jiu-0317/sense_pcb_kicad/docs/Sense_보드_설계검토_기록.docx

# Reptitude Sense 보드 (ESP32-C3) 설계 검토 · 수정 기록

프로젝트: D:\jiu\kicad\sense_pcb_kicad (esp32_c3_mini_1_module.kicad_sch / .kicad_pcb, KiCad 10, git 브랜치 usb_added)

문서 버전: v1.6 · 최초 작성 2026-11-09 · 최종 수정 2026-11-10

용도: 설계 문제를 하나씩 수정할 때 쓰는 체크리스트이자, 새 Claude 세션을 시작할 때 맥락으로 주는 기록이다. 새 논의가 생기면 이 문서의 해당 섹션과 「변경 이력」을 갱신한다.

# 0. 새 세션용 요약 (먼저 읽을 것)

- 보드: SHT40 온습도 → ESP32-C3-MINI-1 → Wi-Fi로 서버 전송. AAA×3(4.5V) → TPS63802 벅-부스트 → 3.3V. 2층, 60.7×37.6mm, 건전지 홀더(BH-AAA-A1AJ024, THT)를 뒷면에 직접 실장.
- 이전 보드 대비 변경: 벅(TPS62162) → 벅-부스트(TPS63802), 건전지 전선 연결 → THT 홀더 직접 실장, 외부 USB-UART → 보드 USB-C(현재 CH340E). 레이아웃은 새로 했고 나머지 회로는 이전에 정상 동작한 보드와 동일.
- 검토 결과: 회로 연결 오류·미배선·쇼트는 없음. 다만 BOM 번호 오류, 안테나가 건전지 위에 놓인 배치, CH340·배터리 체커로 인한 대기전류 증가, TPS 아래 부유 구리섬 등이 확인됨(4장).
- 결정된 방향(3장): MINI-1 유지 + 안테나를 홀더 밖 왼쪽 영역으로 이동, CH340 제거 후 ESP32-C3 내장 USB 사용, BOM 번호는 나중에 일괄 수정, 나머지는 권고대로 수정.
- 아직 안 한 것: KiCad 자체 ERC/DRC(6장 명령어), 내장 USB 전환 후 대기전류 실측, 홀더 극성 실물 확인.

# 1. 보드 개요

Ref | 부품 | 역할 / 메모
U5 | ESP32-C3-MINI-1-N4 | MCU+Wi-Fi, PCB 안테나. 현재 180° 회전, 안테나가 아래쪽 가장자리
U3 | TPS63802DLAT | 벅-부스트 3.3V. EN=VIN, MODE=GND(PFM), PG→GPIO10(R5 100k 풀업)
L1 | XFL4015-471MEC 0.47µH | 데이터시트 권장 인덕터 그대로
R6 / R7 | 511k / 91k | FB 분압 → 3.3V (VFB 500mV)
C5 / C6 | 10µF / 22µF | TPS 입력 / 출력 캡
Q1 + D1 | DMG2305UX + SS14 | 전원 경로: USB 있으면 D1로 VIN 공급, Q1이 배터리 차단. 없으면 Q1 ON
Q2, R8, R9, R10, C7 | AO3401A, 1M, 330k, 100k, 10nF | 배터리 체커: GPIO3로 PMOS 스위치, 분압 → GPIO0(ADC1_CH0)
U2 | CH340E | USB-UART (제거 예정, 3장 D2)
U1 | USBLC6-2SC6 | USB ESD (유지)
J1 | USB4105 USB-C | CC 5.1k(R3/R4). 쉴드 다리 THT → 홀더 영역 위로 못 옮김
U4 | SHT40-AD1F-R2 | I2C SDA=GPIO6, SCL=GPIO5, 풀업 10k(R11/R12), 주소 0x44
S1 / S2 / S3 | SKRPACE010 | BOOT(GPIO9) / EN / GPIO1 사용자 버튼
D2 + R15 | LED + 150Ω | GPIO18 (내장 USB 사용 시 이동 필요)
U6 | BH-AAA-A1AJ024 | AAA×3 홀더, 뒷면. 52×37mm, 핀 간격 11.6mm, Ø3.3 구멍 2개

보드 형상 수치(검토 기준 좌표, mm): 외곽 x 89.23–149.94, y 80.52–118.11. 홀더 외곽 x 97.78–149.78, y 80.84–117.84 → 홀더가 없는 곳은 왼쪽 띠 x 89.23–97.78(폭 약 8.5mm)뿐. 현재 안테나 영역 x 107.2–120.4, y 111.8–117.2. J1(USB) y 약 93–104, MH1 (94.4, 85.1), MH2 (94.4, 113.1).

# 2. 검토 방법과 한계

- 작업 공간에 KiCad 10을 설치할 수 없어서 .kicad_sch / .kicad_pcb를 직접 파싱해 넷리스트·구리 형상·연결성·간격을 계산했다(전 넷 연결 확인, 쇼트 없음, 최소 간격 0.122mm @ J1 SBU2–VBUS).
- 폴더 안 PDF 10종(TPS63802, TPS62162, ESP32-C3-MINI-1, SHT4x, CH340, USBLC6, DMG2305UX, XFL4015, BH-AAA 홀더 도면, ESP32-C3-DevKitM-1 회로도)을 읽고 대조했다.
- KiCad 자체 ERC/DRC는 아직 실행하지 않음 → 6장 명령으로 실행 후 결과를 이 문서에 반영할 것.

# 3. 결정 사항

ID | 날짜 | 내용
D1 | 2026-11-09 | ESP32-C3-MINI-1을 그대로 쓰고, 안테나를 홀더 영역 밖 왼쪽 PCB로 옮긴다. 하우징이 허용하면 보드를 키워 Espressif 권장 킵아웃(안테나 주변 15mm에 구리·배선·부품 없음)을 지키고, 허용하지 않으면 현재 보드 크기로 진행한다.
D2 | 2026-11-09 | CH340E를 제거하고 ESP32-C3 내장 USB Serial/JTAG(IO18=D−, IO19=D+)를 쓴다. 목적: 소비자가 펌웨어 문제 시 USB로 직접 강제 플래싱.
D3 | 2026-11-09 | 내장 USB 전환 후 배터리 단독 대기전류를 측정하고, 많으면 펌웨어에서 D+ 풀업을 켜고 끄도록 한다. 펌웨어가 망가져도 플래싱이 가능해야 하므로 버튼으로 강제하는 방법도 고려 → 검토 의견은 5.3절.
D4 | 2026-11-09 | BOM/LCSC 번호 오류(S-01)는 나중에 한 번에 고친다. 그때까지 주문 금지.
D5 | 2026-11-09 | 그 외 지적 사항은 4장 권고대로 수정한다.
D6 | 2026-11-09 | 배터리 체커(S-04)는 안1로 결정: Q2(AO3401A) 유지 + 게이트 구동 NMOS Q3(AO3400A) 추가, R8을 4V5로. GPIO3=High일 때 측정(펌웨어 로직 반전). 작업 브랜치: git layout_v3.
D7 | 2026-11-09 | 회로도 최종: 과방전 방지 EN 분압·VIN 벌크 캡(S-06)은 적용하지 않음. 대기전류 측정용 솔더 점퍼 JP1 추가, UART0 테스트 패드 TP1~TP3 추가, EN 풀업 중복 정리(R14 삭제).
D8 | 2026-11-10 | PCB 배치에 맞춰 ESP32 핀맵 변경(5.2.2절 표). 데이터시트 기준 검토 결과 문제 없음.

# 4. 수정 항목 체크리스트

우선순위: 치명(주문하면 동작 안 함) > 높음 > 중간 > 낮음. 상태 열은 수정하면서 갱신한다(미착수 / 진행 / 완료 / 보류).

ID | 우선 | 항목 | 근거 / 수정 방법 | 상태
S-01 | 치명 | BOM·LCSC 필드 오류 | 회로도 심볼의 LCSC/MPN이 복사된 채 남음: C1~C6에 C28323(1µF), R1·R3·R4·R6·R7에 C84376(10k). JLC BOM(ver2_mfr)은 일부 수정됐지만 C1~C4, C6, R6, R7이 비어 있음. R6/R7 누락·오값 → 출력 약 1V로 ESP 미동작, C6 1µF → TPS 최소 출력 실효 7µF 미달. → 필드 정리, C6은 0805 22µF 10V X5R 등 실제 22µF 지정. | 보류(D4)
S-02 | 높음 | CH340E 상시 전원 | VCC/V3가 VDD33 → 배터리만으로도 동작, suspend 40µA typ / 150µA max. → D2 결정으로 CH340 제거. | 회로도 완료
S-03 | 높음 | D+ 역류 누설 경로 | D+ 풀업 → USBLC6 I/O→VBUS 다이오드(rail-to-rail) → +VBUS → R1 → VBUSF → R2(100k) → GND. CH340 기준 약 27µA 추정. ESP 내장 USB도 D+ 내부 풀업이 있고 VBUS 감지가 없어 비슷한 경로 가능. → 내장 USB 전환 후 실측, 필요 시 펌웨어로 풀업 OFF(5.3절). | 미착수
S-04 | 중간 | 배터리 체커 Q2가 꺼지지 않음 | R8이 3.3V로 게이트를 당기는데 소스는 배터리 4.5~4.8V → Vgs −1.2~−1.5V, AO3401A Vth −0.5~−1.3V라 ON 유지 → 분압기로 상시 약 11µA. 이전 보드도 같은 구조(측정은 정상). → 안1: R8을 4V5에 연결 + GPIO3로 NMOS(2N7002, 게이트 100k 풀다운) 구동해 Q2 게이트를 당김. → 안2: 스위치 제거, 분압기를 1M/330k 등 고저항으로(약 3.5µA) + C7 유지. [반영] 안1 적용(D6): Q3 AO3400A(G=GPIO3, S=GND, D=Q2 게이트), R8 1M → 4V5, R10 100k는 GPIO3 풀다운으로 용도 변경, 분압 하단은 R20 100k 신규. Q3 LCSC 필드는 S-01 때 함께 입력. | 회로도 완료
S-05 | 낮음 | SS14 역누설 | 배터리 단독 시 VIN→D1(역방향)→VBUSF→R2 경로. 상온 수 µA, 사육장 온도에서 증가. → 대기전류 측정 시 함께 확인. 크면 저누설 다이오드 검토. | 미착수
S-06 | 낮음 | (선택) 과방전 방지·벌크 캡 | TPS EN=VIN이라 1.25V까지 동작 → 알카라인 과방전. → EN에 분압(예: 2.7V 컷오프, 1.7M/1M 수준, 약 1.6µA) 또는 펌웨어 컷오프. → VIN에 47~100µF 벌크 캡: 건전지 말기 Wi-Fi 버스트 전압 강하 완화. [결정] 둘 다 적용하지 않음(D7). 저전압 처리는 필요 시 펌웨어(ADC)로. | 미적용
P-01 | 높음 | 안테나가 건전지 위 | 현재 안테나 영역 전체가 뒷면 홀더(셀 금속 캔, 스프링)와 겹침 → 디튜닝·통신 거리 감소. → D1: 왼쪽 띠로 이동. 배치 가이드는 5.1절. | 결정(D1)
P-02 | 높음 | TPS 아래 B.Cu 부유 구리섬 | VIN_ind / NET_ind(SW) / NET_ind_1(L2) / VDD33_ind 존이 F.Cu+B.Cu로 지정 → B.Cu에 어디에도 연결 안 된 섬 4개(약 21mm²)가 GND 플레인을 끊음. SW 섬은 노이즈원. → 이 존들을 F.Cu 전용으로 변경. GND_ind는 유지 가능. | 미착수
P-03 | 중간 | ESP 3V3 디커플링 거리 | C12(0.1µF)/C13(10µF)가 3V3 핀(3번)에서 9~12mm. → 3번 핀 바로 옆으로 이동(안테나 이동 시 같이 재배치). | 미착수
P-04 | 중간 | SHT40 아래 구리 / 위치 | Sensirion: 패드 외 구리 금지(다이 패드 납땜도 비권장). 현재 F.Cu 일부·B.Cu 전체 GND가 아래에 있음. → 센서 아래 양면 킵아웃, 가능하면 보드 가장자리 + 주변 슬롯으로 열 분리, 열원(TPS, ESP, LED)과 거리 확보. | 미착수
P-05 | 중간 | 솔더마스크 확장 0.1mm | pad_to_mask_clearance 0.1 → 0.5mm 피치(TPS63802, USB-C)에서 패드 사이 마스크 소실. → 0으로 변경(제조사 기본 확장 사용). | 미착수
P-06 | 낮음 | 홀더 핀 길이 | 홀더 핀 12.7mm → 윗면으로 약 11mm 돌출. 납땜 후 절단 필요(조립 지침에 기록). | 미착수
P-07 | 중간 | 홀더 극성 확인 | 도면상 가운데 핀이 −로 보이고 풋프린트(1=GND 가운데, 2=4V5)와 일치하나 도면에 핀 표기가 없음. → 주문 전 실물을 멀티미터로 확인. | 미착수
P-08 | 제약 | USB-C 위치 | USB4105 쉴드 다리 4개가 THT → 뒷면 홀더와 간섭하므로 왼쪽 띠에 남겨야 함(또는 전체 SMD 타입 커넥터로 교체). | —
P-09 | 중간 | 장착 구멍 MH1/MH2 | 안테나를 왼쪽 띠로 옮기면 구멍이 겹치거나 가까워짐. 금속 나사도 금속. → 안테나 쪽 구멍 제거 또는 나일론 나사. 고정은 홀더 Ø3.3 구멍 활용 검토. | 미착수
C-01 | 높음 | LED GPIO18 이동 | 내장 USB가 IO18/IO19를 사용 → LED(D2/R15)를 빈 핀(IO4 또는 IO7)으로 이동. [반영] R15 → GPIO7. | 회로도 완료

# 5. 상세 가이드

## 5.1 안테나 + USB 왼쪽 띠 배치 (P-01, P-08, P-09) — Espressif PCB Layout 가이드 반영

가이드 요지(ESP32-C3 Hardware Design Guidelines, PCB Layout Design): ① 모듈의 PCB 안테나를 베이스 보드 밖으로 내보내고 급전점(feed point)을 보드 가장자리 가까이 둘 것(가장 권장). ② 밖으로 못 내면 급전점을 최대한 가장자리에 붙이고, 안테나 양옆과 아래의 베이스 보드를 잘라낼 것. ③ 모듈을 보드 가운데 두고 사방을 파내는 배치는 금지. ④ 안테나 근처 베이스 보드에 GND 동박과 촘촘한 GND 비아. ⑤ 하우징 안에서 안테나 주변 모든 방향 15mm 이상 여유. ⑥ 최종 제품에서 통신 거리·처리량 시험. ESP32-C3-MINI-1의 급전점은 안테나의 왼쪽 끝(안테나를 위로 둔 윗면 기준, 1번 핀 쪽).

- 모듈 방향: 90° 반시계 회전(안테나가 −x, 왼쪽을 향함). 이때 급전점(안테나 왼쪽 끝)은 아래쪽(+y)으로 감 → 모듈을 보드 왼쪽 아래 모서리에 두어 급전점이 모서리(가장자리) 가까이 오게 함.
- 안1(권장) 안테나 돌출: 모듈 패드부를 왼쪽 띠에 두고 안테나 부분(약 5.4×13.2mm)이 베이스 보드 왼쪽 가장자리 밖으로 나가게 배치. 베이스 보드 외곽은 그대로, 제품 폭만 약 5.4mm 늘어남(하우징 확인). 안테나–홀더 간격 약 8~9mm로 증가.
- 안2 보드 안 + 컷아웃: 안테나를 왼쪽 띠 안(x 약 89.2–94.6)에 두고, 안테나 아래와 양옆(위·아래) 베이스 보드를 Edge.Cuts로 U자 노치 형태로 제거. 급전점 쪽(아래)을 보드 가장자리에 최대한 붙임. 안테나–홀더 간격 약 3~5mm.
- 공통: USB-C는 왼쪽 띠 위쪽으로 이동(쉴드 THT 때문에 왼쪽 띠 고정). MH1(왼쪽 위)은 USB와, MH2(왼쪽 아래)는 안테나와 겹치므로 제거 또는 이동(금속 나사는 안테나에서 멀리). 안테나 영역 양면 구리·부품·배선 금지(모듈 풋프린트 킵아웃 유지). 모듈 본체 아래·주변은 GND 동박 + 촘촘한 GND 비아, 모듈 GND 패드(49) 비아 9개 이상.
- 보드를 늘릴 수 있으면: 왼쪽으로 늘려 안테나–셀/홀더 금속 간격 15mm를 목표로(D1).
- 시제품에서 실제 설치 위치 RSSI·통신 거리를 측정하고 가능하면 DevKit과 비교. 부족하면 ESP32-C3-MINI-1U(같은 핀, U.FL 외장 안테나) 검토.

## 5.2 내장 USB 전환 회로 변경 (D2)

- U2(CH340E)와 전용 디커플링(C3/C4 중 CH340용) 삭제. USBLC6 출력 D+ → U5 27번(IO19), D− → U5 26번(IO18). 각 라인에 0Ω 자리 확보(Espressif 참고 회로와 동일).
- 유지: USB-C CC 5.1k(R3/R4), USBLC6, VBUS 전원 경로(R1, D1, Q1, R2), BOOT(S1, GPIO9)·EN(S2) 버튼, GPIO8 풀업(R18 — 다운로드 모드 진입에 GPIO8 High 필요), GPIO2 풀업(R17).
- [회로도 반영 2026-11-09] CH340E·C3·C4 삭제. USBD+ → USBLC6 I/O2(3,4) → U5 27번(IO19), USBD− → USBLC6 I/O1(1,6) → U5 26번(IO18) 확인. 0Ω 직렬 자리는 넣지 않음(선택 사항). 레이아웃에서는 커넥터 → USBLC6 패드 → ESP 순서로 지나가도록 배선(클램프가 경로 위에 오게).
- UART0(TXD0 31번, RXD0 30번)은 테스트 패드로 남겨 두면 USB 문제 시 디버깅 백업이 됨(선택).
- 펌웨어 설정: Arduino는 「USB CDC On Boot: Enabled」, ESP-IDF는 콘솔을 USB Serial/JTAG로.
- 한계: 기능 고정(시리얼+JTAG)이라 HID 같은 커스텀 USB 장치는 불가. 딥슬립 중에는 USB가 끊기고 COM 포트가 사라짐.

## 5.2.1 회로도 최종 추가 사항 (D7)

- JP1 (Jumper:SolderJumper_2_Bridged, 풋프린트 SolderJumper-2_P1.3mm_Bridged_RoundedPad1.0x1.5mm): BAT+(홀더 +) ↔ 4V5 사이. 평소 연결 상태, 대기전류 측정 시 가운데 동박을 칼로 끊고 멀티미터를 직렬 연결(빨강=BAT+ 쪽, 검정=4V5 쪽), 측정 후 납으로 재연결. PCB에서는 윗면 손 닿는 곳에 배치.
- 측정 팁: 부팅·Wi-Fi 중에는 µA 레인지의 내부 저항 때문에 리셋될 수 있음 → 점퍼를 이은 상태나 mA 레인지로 시작해 딥슬립 진입 후 µA로 전환. 전류 모드로 전원–GND 사이에 대지 말 것.
- TP1~TP3 (Connector:TestPoint, TestPoint_Pad_D1.5mm): TP1=RXD0(30번), TP2=TXD0(31번), TP3=GND. 윗면에 2.54mm 간격 일렬 배치, 실크 RX/TX/GND. 외부 USB-UART는 보드 TX→어댑터 RX, 보드 RX←어댑터 TX, GND만 연결(어댑터 전원 핀 연결 금지).
- EN: R14 삭제, R16 10k + C11 1µF + C10 0.1µF (Espressif 권장 10k/1µF 수준).
- 남은 회로도 항목: S-01 BOM 필드(Q3 LCSC 포함, JP1·TP1~3·FID·MH는 실장 부품 아님), MH1/MH2 유지 여부는 레이아웃에서 결정(P-09).

## 5.2.2 ESP32-C3 핀맵 (D8, 2026-11-10)

모듈 핀 | GPIO | 연결 | 데이터시트 근거 / 메모
5 | IO2 | R17 10k 풀업 | 스트래핑. Table 4-3: SPI·다운로드 부트 모두 1 권장(글리치 방지)
6 | IO3 | NC | 예비(ADC1_CH3)
8 | EN | R16 10k + C11 1µF + C10, S2 | EN 플로팅 금지. RC 약 11ms > 스트래핑 hold 3ms
12 | IO0 | S3 사용자 버튼, R15 10k 풀업, C14 | 비스트래핑. XTAL_32K_P 겸용(32k 크리스털 미사용)
13 | IO1 | 배터리 ADC (R9 330k / R11 100k, C7) | ADC1_CH1: ADC1은 공장 보정됨(ADC2는 미보정·일부 리비전 불가)
16 | IO10 | LED D2 (R19 150Ω) | 일반 GPIO
18 | IO4 | SHT40 SDA, R13 10k | I2C는 GPIO 매트릭스로 아무 핀 가능. MTMS(핀 JTAG 기본 비활성)
19 | IO5 | SHT40 SCL, R12 10k | SDA와 인접 핀
20 | IO6 | Q3 게이트(배터리 체커), R10 100k 풀다운 | 딥슬립 시 핀이 떠도 풀다운으로 Q3 OFF. High=측정
21 | IO7 | TPS63802 PG, R5 100k 풀업 | 오픈드레인 입력
22 | IO8 | R18 10k 풀업 | 스트래핑: 다운로드 부트에 1 필요, ROM 로그 출력 제어
23 | IO9 | S1 BOOT, R14 10k 풀업, C9 0.1µF | 스트래핑: 0이면 다운로드 모드. RC 약 1ms로 EN보다 먼저 안정
26/27 | IO18/IO19 | USB D−/D+ | USB Serial/JTAG
30/31 | RXD0/TXD0 | 테스트 패드 RX0/TX0 | UART0 백업

참고: 회로도 레퍼런스 번호가 재정렬됨(예: 배터리 분압 하단 R11, GPIO9 풀업 R14, LED 저항 R19, 테스트 패드 RX0/TX0/GND0). 4장 체크리스트의 부품 번호는 v1.3 이전 기준.

펌웨어 메모: 사용자 버튼을 IO0에 둔 것은 딥슬립 해제에 유리함(ESP32-C3는 GPIO0~5만 딥슬립 GPIO 웨이크업 가능 — 칩 문서 기준). SHT40은 Wire.begin(4, 5).

## 5.3 강제 플래싱과 D+ 풀업 제어 (D3) — 검토 의견

- 핵심: GPIO9(BOOT)를 Low로 누른 채 리셋(EN)하면 ESP32-C3는 ROM 부트로더로 들어가고, ROM이 직접 USB Serial/JTAG 다운로드 모드("wait usb download")를 띄운다. 플래시의 펌웨어는 실행되지 않으므로 펌웨어 로직과 무관하게 강제 플래싱이 가능하다.
- 펌웨어가 USB 풀업을 꺼 두었더라도, EN 버튼(CHIP_PU)으로 리셋하면 칩 레지스터가 초기화되어 ROM 상태로 다시 시작한다. 따라서 「버튼으로 풀업 강제 ON」 회로는 BOOT+EN 버튼으로 이미 대체될 가능성이 높다 → 별도 회로 추가 전에 시제품에서 확인 권장.
- 꼭 지킬 것: eFuse DIS_USB_SERIAL_JTAG, DIS_USB_SERIAL_JTAG_DOWNLOAD_MODE를 굽지 말 것(굽으면 USB 강제 플래싱이 영구히 불가).
- 소비자용 복구 절차(안): ① USB 연결 ② BOOT 누른 상태 유지 ③ EN 짧게 누름 ④ BOOT 놓음 ⑤ 플래싱 도구 실행 ⑥ 완료 후 EN 눌러 재시작.
- 대기전류가 많게 나오면: 딥슬립 진입 전에 펌웨어에서 USB D+ 풀업을 끄고(USB Serial/JTAG 패드 설정), 깨어난 뒤 필요할 때만 켠다. 이 경우에도 BOOT+EN 복구 경로는 그대로 유효.

## 5.4 대기전류 예산 (배터리 단독, 추정)

항목 | 전류 | 비고
TPS63802 Iq | 약 11µA | 데이터시트 typ
ESP32-C3 딥슬립 | 약 5µA | RTC 타이머+메모리
CH340E (현재) | 40µA typ / 150µA max | D2로 제거 예정
D+ → USBLC6 → VBUS → R2 누설 | 약 27µA (CH340 기준 추정) | 내장 USB 후 실측(S-03)
Q2 분압기 상시 전류 | 약 11µA | S-04 수정 시 0~3.5µA
SS14 역누설 | 수 µA (온도↑ 시 증가) | S-05
설계 목표 합계 | 약 16µA | TPS + ESP 딥슬립
현재 구조 추정 합계 | 약 80~100µA | 측정으로 확인 필요

## 5.5 라우팅 검토 (2026-11-10, 16:15 저장본)

범위: 연결 완결성, TPS63802 전원부, 전원 배선 폭, ESP32 모듈, 안테나, USB, 배터리 측정부, SHT40, GND 면 연속성, 제조·조립. GND 비아 개수·배치는 사용자가 추가할 예정이라 제외. KiCad DRC가 아니라 파일 직접 파싱으로 확인했으므로 최종은 DRC로 재확인.

ID | 우선 | 문제 | 조치
R-01 | 해제 | (v1.6 정정) U3 핀 사이 GND 비아 0.5/0.2mm는 JLCPCB 현행 기준(2층 최소 홀 0.15, 권장 0.2, 지름 0.45 이상이면 추가비 없음)에 맞음. 패드 간격 0.197mm도 SMD 패드 간 0.15·보드 규칙 0.15 이상, 홀–패드 0.35mm(기준 0.2). | 조치 불필요. 유지.
R-02 | 높음 | JP1(D7에서 결정)이 회로도·PCB 모두에 없음. R1(0R)은 VBUS 경로라 배터리 대기전류 측정용이 아님. | 의도적 삭제인지 확인. 필요하면 배터리 경로(4V5)에 다시 추가.
R-03 | 중간 | SHT40 디커플링 C8(100nF)이 U4 3번 핀까지 배선 약 9mm. | C8을 U4 3·4번 핀 바로 옆으로 이동.
R-04 | 중간 | B.Cu VDD33 배선(107.4,116.9→118,107.8)과 GPIO1 배선(118.2,109.9→144.4,101.7)이 이어져 B면 GND를 길게 가름. (107.4,116.9) 비아가 보드 아래 가장자리까지 막아 아래쪽 영역은 오른쪽 끝(x>145)으로만 연결. | 해당 비아를 위로 올려 아래로 GND가 지나가게 하거나 그 구간을 F.Cu로. 갈라진 양쪽을 GND 비아로 이음.
R-05 | 중간 | 안테나 킵아웃 모서리(보드 쪽 0.85mm 띠, x 94.24–95.09)에 GND 채움이 0.1–0.3mm까지 붙음. GND 비아(91.3,96.9) 2.1mm, R3 2.4mm, C12 0.8mm. | 킵아웃 위·아래로 약 3mm 연장한 룰 영역(채움·비아 금지) 추가, (91.3,96.9) 비아 이동.
R-06 | 중간 | 실크 문구 Ver.2 Reptitude Sense, ENABLE, GPIO1, BOOT가 보드 밖(y 74–78)에 있어 인쇄 안 됨. S3는 이제 IO0이라 GPIO1 표기도 틀림. | 보드 안으로 이동, S3 표기를 USER(IO0)로.
R-07 | 중간 | 홀더(U6) 극성 실크 없음(B면). 풋프린트는 1번=GND(y 99.3), 2번=+(y 87.7). | 데이터시트로 극성 확인(P-07) 후 B.SilkS에 +/− 표기.
R-08 | 높음 | pad_to_mask 0.1 그대로(P-05). 마스크 댐 = 패드 간격 − 0.2 → U3 0.05mm, J1(다른 넷) 0.0mm로 JLCPCB 최소 0.10mm(녹색, 1oz) 미달 → 패드 사이 마스크 없음, 브리지 위험. JLCPCB는 개구를 패드와 1:1로 만듦. | 0으로 변경 → U3 0.25, J1 0.20, U1 0.35mm.
R-09 | 낮음 | VBUS 배선이 J1 B8(SBU2, 미연결)과 0.122mm, B5(CC2)와 0.175mm. JLCPCB 패드–트랙 0.1은 만족하나 보드 규칙 0.15 미만이라 DRC 오류. 마스크 0.1이면 트랙이 노출됨(개구–트랙 0.09 필요). | 배선 살짝 이동(R-08 수정 시 노출 문제는 해소).
R-10 | 낮음 | VIN 0.4mm × 29mm. 최저 전압 2.7V, 약 0.5A 기준 전압강하 약 17mV로 허용 범위. | 여유 있으면 0.5–0.75mm로.
R-11 | 낮음 | ADC(GPIO1) 배선 약 49mm. C7이 분압기 쪽에 있어 실용상 문제는 적음. | 선택: 노이즈 시 모듈 쪽에 소용량 캡 추가 검토.
R-12 | 낮음 | 부품 번호 실크 대부분 0.7mm/선 0.1mm(C7은 0.39mm). JLCPCB 최소 글자 높이 1.0mm·선 0.15mm 미만 → 흐리거나 안 읽힐 수 있음. 풋프린트 실크 선 0.12–0.127mm도 기준 미만이나 라이브러리 기본값. | 필요한 글자만 1.0mm/0.15mm로. 패드–실크 0.15mm는 모두 만족.

JLCPCB 기준 대조(v1.6, jlcpcb.com/capabilities/pcb-capabilities): 비아 홀–트랙 ≥0.2, PTH 홀–구리 ≥0.28, NPTH–트랙 ≥0.2, 홀 간격 모두 만족. NPTH J1 0.65·홀더 3.3mm(최소 0.5). PTH 링 홀더 0.5mm, J1 쉴드 0.2mm(권장 0.25, 최소 0.18 — 라이브러리 값). 외곽–구리 0.5mm(기준 0.2). 보드 규칙(간격 0.15, 비아 0.45)은 JLCPCB보다 보수적이라 유지해도 됨.

정상 확인: 미배선 없음, 회로도와 PCB 넷 일치, 다른 넷 간 0.15mm 미만 간격은 R-09뿐, 외곽 이격 ≥0.5mm. TPS 입력 루프(C5–10번–8번–GND_ind) 약 3.5mm·출력 C6 근접, SW/L2 구리 짧음, FB 분압기 핀 근처·SW와 분리, R7 GND가 AGND(3번)로 연결. ESP 3번 핀 옆 C12(0.1µF)·C13(10µF), EN 1µF(C11) 모듈 근처. USB는 J1→USBLC6(약 4mm)→모듈, 비아 없음, 길이 D+ 19.3 / D− 22.8mm(FS에 무관), CC 5.1k. 안테나는 노치 위로 돌출, 풋프린트 킵아웃 안에 구리 없음. 모듈 GND 패드 전부 연결. SHT40 킵아웃 유지. Q2/Q3 배터리 스위치 소형 배치.

# 6. ERC/DRC 실행 명령 (PowerShell)

cd D:\jiu\kicad\sense_pcb_kicad

$k="C:\Program Files\KiCad\10.0\bin\kicad-cli.exe"

& $k sch erc --severity-all -o erc.rpt esp32_c3_mini_1_module.kicad_sch

& $k pcb drc --schematic-parity --severity-all -o drc.rpt esp32_c3_mini_1_module.kicad_pcb

& $k sch export pdf -o sch.pdf esp32_c3_mini_1_module.kicad_sch

# 7. 정상으로 확인된 항목

- 넷 연결: 모든 넷 끊김 없음, 서로 다른 넷 간 쇼트 없음.
- ESP32-C3 핀 매핑: 3V3(3), EN(8), IO0/1/2/3/5/6/8/9/10/18, TXD0(31)/RXD0(30) 모두 데이터시트와 일치. UART 크로스(CH340 TXD→RXD0, TXD0→CH340 RXD) 정상.
- 스트래핑: GPIO2·GPIO8 10k 풀업, GPIO9 BOOT 버튼+10k 풀업+0.1µF, EN 10k×2 + 1.1µF(권장 10k/1µF 수준).
- TPS63802: 핀 기능·풋프린트가 DLA0010A 랜드 패턴과 일치, 핀 8 페이스트 있음(2분할), FB 511k/91k=3.3V, MODE=GND, PG→GPIO10(100k), L1 0.47µH XFL4015, C5/C6/L1 배치와 IC 가운데 GND 비아는 TI 예시 형태. 비아 텐팅 ON.
- 전원 경로: USB 시 Q1 게이트 5V·소스 약 4.7V → OFF로 배터리 차단, 배터리 시 Q1 ON(Vgs −2.7V에서도 RDS(on) ≤100mΩ), 배터리 역삽입 시에도 Q1이 차단.
- USB-C: CC 5.1k, D+/D− 양면 핀 연결, USBLC6 방향(I/O1 1↔6, I/O2 3↔4, VBUS 5) 정상. VBUS 0.3mm 트랙은 0.5A 수준에 충분.
- SHT40: 핀(SDA1/SCL2/VDD3/VSS4), 10k 풀업(최소 390Ω 이상), C8 100nF 3mm 이내, 다이 패드 없음.
- 홀더 풋프린트: Ø3.3 구멍 간격 23.5mm, 핀 간격 11.6mm가 도면과 일치, 뒷면 배치 시 미러 방향이 맞음.
- J1 USB-C: 보드 가장자리 대비 약 0.36mm 돌출(플러그 체결에 유리).
- 배터리 ADC: GPIO0(ADC1_CH0), 4.8V → 약 1.12V, 2.7V → 약 0.63V, C7 10nF로 샘플링 안정.

# 8. 데이터시트 근거 메모

- TPS63802: 입력 1.3–5.5V(시동 1.8V 이상), UVLO 하강 1.25V. 권장 L 0.47µH(실효 0.37–0.57), 출력 실효 C ≥7µF(VO>2.3V), 입력 실효 ≥4µF, 권장 출력 22µF·입력 10µF. VFB 500mV, 하측 저항 ≤100k. 레이아웃: 입출력 캡 IC에 최대한 가깝게, 전력/제어 GND 분리 후 IC 근처에서 연결, FB 트레이스는 L1/L2에서 멀리. EN 임계 상승 1.1V/하강 1.0V(분압으로 UVLO 설정 가능).
- ESP32-C3-MINI-1: 13.2×16.6mm, GND 1·2·11·14·36–53, 3V3=3, EN=8, IO18=USB_D−(26), IO19=USB_D+(27). 딥슬립 약 5µA. 안테나 킵아웃: 안테나 아래 구리 금지, 가장자리 배치, 권장 위치가 안 되면 주변 15mm 비움.
- ESP32-C3 부트: GPIO9 Low로 리셋 → ROM 다운로드 모드(USB Serial/JTAG 또는 UART0). GPIO8은 High 필요.
- SHT4x: VDD 1.08–3.6V, 풀업 ≥390Ω(VDD≥1.62V), 센서 아래 패드 외 구리 금지, 다이 패드 납땜 비권장.
- CH340: 3.3V 동작 시 V3=VCC, 동작 4–12mA, USB suspend 0.04–0.15mA(CH340C/N/E/X), 내부 D+ 풀업 내장. CH340X는 CH340E 개선판(6번 핀 DTR 전환 가능, 역류 방지) — 내장 USB로 가면 불필요.
- USBLC6-2SC6: rail-to-rail 구조(I/O→VBUS 다이오드), 누설 ≤150nA.
- DMG2305UX: VGS(th) −0.5~−0.9V, VGSS ±8V, RDS(on) ≤100mΩ@−2.5V. 핀 1=G, 2=S, 3=D.
- XFL4015-471: 0.47µH, DCR 7.6mΩ, Isat(20%) 5.4A, 랜드 0.98×3.4mm, 중심 간격 2.37mm.
- BH-AAA-A1AJ024: 52×37×12.8mm, 2-Ø3.3 구멍(간격 23.5), 핀 간격 11.6, 핀 길이 12.7mm.

# 9. 지적 위치도

노란 번호: 1=안테나(P-01), 2=TPS 부유 구리섬(P-02), 3=Q2 배터리 체커(S-04), 4=CH340(S-02), 5=ESP 디커플링(P-03), 6=SHT40(P-04). 파란 점선=뒷면 홀더, 빨간 영역=현재 안테나.

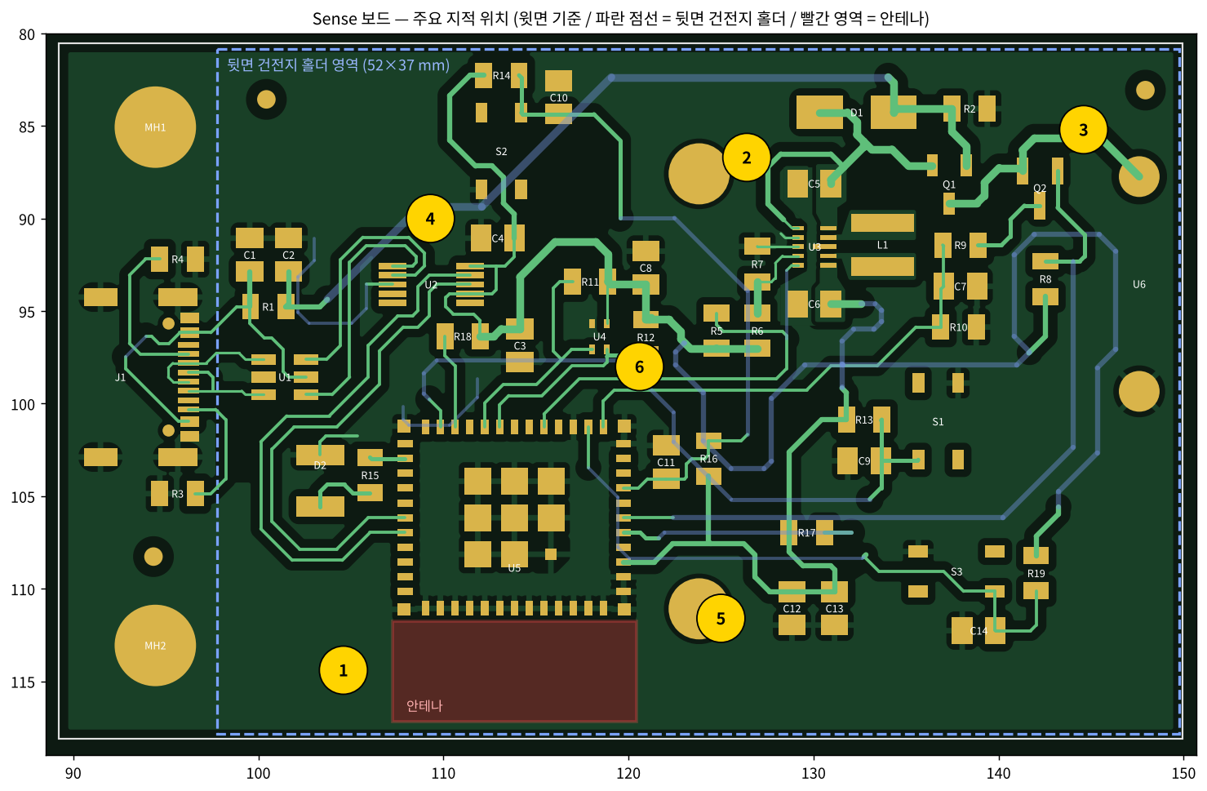
[picture p1: figure]

# 10. 열린 질문 / 다음 확인

- 하우징 크기: 보드를 왼쪽으로 늘려 안테나 15mm 확보가 가능한가?
- 내장 USB 전환 후 배터리 단독 대기전류 실측값(목표 약 16~20µA) — JP1로 측정.
- BOOT+EN 복구 경로로 충분한지(5.3절) — 별도 풀업 강제 버튼이 필요한지 시제품에서 결정.
- ERC/DRC 결과 반영.

# 11. 변경 이력

날짜 | 내용
2026-11-09 | v1.0 최초 작성: 회로·PCB 검토 결과, 결정 D1~D5, 수정 체크리스트, 내장 USB 전환·안테나 재배치 가이드.
2026-11-09 | v1.1 회로도 수정 확인(브랜치 layout_v3): CH340 제거·내장 USB 연결, LED GPIO7 이동, 배터리 체커 안1 적용(D6). S-02·S-04·C-01 상태 갱신.
2026-11-09 | v1.2 회로도 최종 확인(D7): JP1·TP1~3 추가, R14 삭제, S-06 미적용 결정. 다음 단계는 레이아웃.
2026-11-09 | v1.3 5.1절을 Espressif PCB Layout 가이드 기준으로 갱신(급전점 위치, 안테나 돌출 권장, 컷아웃 대안, 모듈 방향·모서리 배치).
2026-11-10 | v1.4 ESP32 핀맵 변경 검토(D8, 5.2.2절).
2026-11-10 | v1.5 라우팅 검토(5.5절, R-01~R-11).
2026-11-10 | v1.6 JLCPCB 현행 제조 기준으로 재검토: R-01 해제(비아 0.2mm 허용), R-08 높음으로 상향, R-09 보강, R-12 추가.
