jiu-0317/sense_pcb_kicad/ver2_mfr/BOM.csv

Reference | Qty | Value | DNP | Exclude from BOM | Exclude from Board | Footprint | Datasheet | Description_1 | MANUFACTURER | MF_part_number | Package | LCSC
C5,C13 | 2 | 10uF |  |  |  | Custom:CAPC2012X95N | https://www.lcsc.com/datasheet/C17024.pdf,https://www.lcsc.com/datasheet/C28323.pdf | 10uF ±10% 10V Ceramic Capacitor X5R 0805,1uF ±10% 50V Ceramic Capacitor X7R 0805 | Samsung Electro-Mechanics | CL21A106KPFNNNE,CL21B105KBFNNNE | 0805 | C17024,C28323
R2,R5,R10 | 3 | 100k |  |  |  | Custom:RESC2012X60N | https://www.lcsc.com/datasheet/C84376.pdf,https://www.lcsc.com/datasheet/C96346.pdf | 125mW 100kΩ 150V Thick Film Resistor ±100ppm/℃ ±1% 0805 Chip Resistor - Surface Mount RoHS,125mW 10kΩ 150V Thick Film Resistor ±100ppm/℃ ±1% 0805 Chip Resistor - Surface Mount RoHS | YAGEO | RC0805FR-07100KL,RC0805FR-0710KL | 0805 | C84376,C96346
C7 | 1 | 10nF |  |  |  | Custom:CAPC2012X95N | https://www.lcsc.com/datasheet/C1710.pdf | 10nF ±10% 50V Ceramic Capacitor X7R 0805 | Samsung Electro-Mechanics | CL21B103KBANNNC | 0805 | C1710
U1 | 1 | USBLC6-2SC6 |  |  |  | Package_TO_SOT_SMD:SOT-23-6 | https://www.st.com/resource/en/datasheet/usblc6-2.pdf | ESD DIODE 5.25VWM 17VC SOT-23-6L | ST | USBLC6-2SC6 | SOT-23-6L | C7519
Q2 | 1 | AO3401A |  |  |  | Package_TO_SOT_SMD:SOT-23 | http://www.aosmd.com/pdfs/datasheet/AO3401A.pdf | 30V 4A Surface Mount SOT-23 | AOS | AO3401A | SOT-23 | C15127
C1,C2,C3,C4 | 4 | 470n |  |  |  | Custom:CAPC2012X95N | https://www.lcsc.com/datasheet/C28323.pdf | 1uF ±10% 50V Ceramic Capacitor X7R 0805 | Samsung Electro-Mechanics | CL21B105KBFNNNE | 0805 | C28323
C6 | 1 | 22uF |  |  |  | Custom:CAPC2012X95N | https://www.lcsc.com/datasheet/C28323.pdf | 1uF ±10% 50V Ceramic Capacitor X7R 0805 | Samsung Electro-Mechanics | CL21B105KBFNNNE | 0805 | C28323
C11 | 1 | 1uF |  |  |  | Custom:CAPC2012X95N | https://www.lcsc.com/datasheet/C28323.pdf | 1uF ±10% 50V Ceramic Capacitor X7R 0805 | Samsung Electro-Mechanics | CL21B105KBFNNNE | 0805 | C28323
D1 | 1 | SS14 |  |  |  | Diode_SMD:D_SMA | https://www.vishay.com/docs/88746/ss12.pdf | DIODE SCHOTTKY 40V SMA(DO-214AC) | VISHAY | SS14-E3/61T | SMA(DO-214AC) | C47460
R1 | 1 | 0R |  |  |  | Custom:RESC2012X60N | https://www.lcsc.com/datasheet/C84376.pdf | 125mW 10kΩ 150V Thick Film Resistor ±100ppm/℃ ±1% 0805 Chip Resistor - Surface Mount RoHS | YAGEO | RC0805FR-0710KL | 0805 | C84376
R3,R4 | 2 | 5k1 |  |  |  | Custom:RESC2012X60N | https://www.lcsc.com/datasheet/C84376.pdf | 125mW 10kΩ 150V Thick Film Resistor ±100ppm/℃ ±1% 0805 Chip Resistor - Surface Mount RoHS | YAGEO | RC0805FR-0710KL | 0805 | C84376
R6 | 1 | 511k |  |  |  | Custom:RESC2012X60N | https://www.lcsc.com/datasheet/C84376.pdf | 125mW 10kΩ 150V Thick Film Resistor ±100ppm/℃ ±1% 0805 Chip Resistor - Surface Mount RoHS | YAGEO | RC0805FR-0710KL | 0805 | C84376
R7 | 1 | 91k |  |  |  | Custom:RESC2012X60N | https://www.lcsc.com/datasheet/C84376.pdf | 125mW 10kΩ 150V Thick Film Resistor ±100ppm/℃ ±1% 0805 Chip Resistor - Surface Mount RoHS | YAGEO | RC0805FR-0710KL | 0805 | C84376
R11,R12,R13,R14,R16,R17,R18,R19 | 8 | 10k |  |  |  | Custom:RESC2012X60N | https://www.lcsc.com/datasheet/C84376.pdf | 125mW 10kΩ 150V Thick Film Resistor ±100ppm/℃ ±1% 0805 Chip Resistor - Surface Mount RoHS | YAGEO | RC0805FR-0710KL | 0805 | C84376
U2 | 1 | CH340E |  |  |  | Package_SO:MSOP-10_3x3mm_P0.5mm | https://www.mpja.com/download/35227cpdata.pdf | USB to Serial Port Chip CH340 | WCH | CH340E | MSOP-10 | C99652
R8 | 1 | 1M |  |  |  | Custom:RESC2012X60N | https://www.lcsc.com/datasheet/C107700.pdf | 125mW 1MΩ 150V Thick Film Resistor ±100ppm/℃ ±1% 0805 Chip Resistor - Surface Mount RoHS | YAGEO | RC0805FR-071ML | 0805 | C107700
R15 | 1 | 150 |  |  |  | Custom:RESC2012X60N | https://www.lcsc.com/datasheet/C114523.pdf | 150Ω 125mW 150V Thick Film Resistor ±100ppm/℃ ±1% 0805 Chip Resistor - Surface Mount RoHS | YAGEO | RC0805FR-07150RL | 0805 | C114523
R9 | 1 | 330k |  |  |  | Custom:RESC2012X60N | https://www.lcsc.com/datasheet/C114528.pdf | 125mW 330kΩ 150V Thick Film Resistor ±100ppm/℃ ±1% 0805 Chip Resistor - Surface Mount RoHS | YAGEO | RC0805FR-07330KL | 0805 | C114528
S1,S2,S3 | 3 | SKRPACE010 |  |  |  | Custom:SW_SKRPACE010 | https://www.lcsc.com/datasheet/C139797.pdf | Switch Tactile N.O. SPST Button J-Bend 0.05A 16VDC 2.55N SMD Automotive T/R | ALPSALPINE | SKRPACE010 | SMD-4P,4.2x3.2mm | C139797
Q1 | 1 | DMG2305UX-13 |  |  |  | Custom:DMG2305UX-13 | https://s3.amazonaws.com/snapeda/datasheet/DMG2305UX-13_Diodes_Inc..pdf | MOSFET P-CH 20V 5A SOT-23 | Diodes Inc. | DMG2305UX-13 | SOT-23 | C144153
U3 | 1 | TPS63802DLAT |  |  |  | Custom:TPS63802DLAT | https://www.ti.com/lit/gpn/tps63802 | High-efficiency, low-IQ step-down/step-up converter in DFN package | TI | TPS63802DLAT | VSON-10(2x3) | C1849531
C8 | 1 | 100nF |  |  |  | Custom:CAPC2012X95N | https://www.lcsc.com/datasheet/C1852967.pdf | 100nF ±10% 10V Ceramic Capacitor X7R 0805 | YAGEO | CC0805KRX7R6BB104 | 0805 | C1852967
C9,C10,C12,C14 | 4 | 0.1uF |  |  |  | Custom:CAPC2012X95N | https://www.lcsc.com/datasheet/C1852967.pdf | 100nF ±10% 10V Ceramic Capacitor X7R 0805 | YAGEO | CC0805KRX7R6BB104 | 0805 | C1852967
U5 | 1 | ESP32-C3-MINI-1-N4 |  |  |  | Custom:XCVR_ESP32-C3-MINI-1-N4 | https://www.lcsc.com/datasheet/C2838502.pdf | Transceiver On-board PCB Antenna -98dBm SMD,16.6x13.2mm RF Transceiver Modules and Modems RoHS | Espressif Systems | ESP32-C3-MINI-1-N4 | SMD,16.6x13.2mm | C2838502
D2 | 1 | LED |  |  |  | Custom:XL-3528SURC | https://www.lcsc.com/datasheet/C2843800.pdf | LED RED WATER CLEAR SMD | XINGLIGHT | XL-3528SURC | SMD3528-2P | C2843800
J1 | 1 | USB_C_Receptacle_USB2.0_16P |  |  |  | Connector_USB:USB_C_Receptacle_GCT_USB4105-xx-A_16P_TopMnt_Horizontal | https://www.usb.org/sites/default/files/documents/usb_type-c.zip | USB Type C Receptacle for USB 2.0, SMT Type, PCB Top Mount | Global Connector Technology | USB4105-GF-A-060 | SMD | C3025063
U6 | 1 | BH-AAA-A1AJ024 |  |  |  | Custom:BAT-TH_BH-AAA-A1AJ024 | https://www.lcsc.com/datasheet/C5290193.pdf | BATTERY HOLDER CYLINDRICAL AAA | MYOUNG | BH-AAA-A1AJ024 | - | C5290193
U4 | 1 | SHT40-AD1F-R2 |  |  |  | Custom:SHT4X | https://jlcpcb.com/api/file/downloadByFileSystemAccessId/8590907640283279360 | -40℃~+125℃ 0%RH~100%RH 1.08V~3.6V 16bit 400nA I2C ±0.2℃ ±1.8%RH DFN-4(1.5x1.5) Temperature and Humidity Sensor ROHS | Sensirion | SHT40-AD1F-R2 | DFN-4(1.5x1.5) | C7461846
L1 | 1 | 0.47uH |  |  |  | Custom:xfl4015_inductor | https://www.coilcraft.com/getmedia/84927b8b-f089-421b-a7f4-a0fa23afe908/xfl4015.pdf | FIXED IND 470nH SMD,4x4mm | Coilcraft | XFL4015-471MEC | SMD,4x4mm | C18221164
