jiu-0317/sense_pcb_kicad/esp32_c3_mini_1_module.csv

Reference | Qty | Value | DNP | Exclude from BOM | Exclude from Board | Footprint | Datasheet | Description_1 | MANUFACTURER | MF_part_number | Package | LCSC
C1 | 1 | 1uF |  |  |  | Custom:CAPC2012X95N | https://www.lcsc.com/datasheet/C28323.pdf | 1uF ±10% 50V Ceramic Capacitor X7R 0805 | Samsung Electro-Mechanics | CL21B105KBFNNNE | 0805 | C28323
C2,C5,C7 | 3 | 0.1uF |  |  |  | Custom:CAPC2012X95N | https://www.lcsc.com/datasheet/C1852967.pdf | 100nF ±10% 10V Ceramic Capacitor X7R 0805 | YAGEO | CC0805KRX7R6BB104 | 0805 | C1852967
C3 | 1 | 10uF |  |  |  | Custom:CAPC2012X95N | https://www.lcsc.com/datasheet/C17024.pdf | 10uF ±10% 10V Ceramic Capacitor X5R 0805 | Samsung Electro-Mechanics | CL21A106KPFNNNE | 0805 | C17024
C4 | 1 | 10uf |  |  |  | Custom:CAPC2012X95N | ~ | 10uF ±20% 10V Ceramic Capacitor X5R 0805 | Kyocera AVX | 0805ZD106MAT2A | 0805 | C2170995
C6 | 1 | 10nF |  |  |  | Custom:CAPC2012X95N | https://www.lcsc.com/datasheet/C1710.pdf | 10nF ±10% 50V Ceramic Capacitor X7R 0805 | Samsung Electro-Mechanics | CL21B103KBANNNC | 0805 | C1710
C8 | 1 | 22uf |  |  |  | Custom:CAPC2012X95N | https://www.lcsc.com/datasheet/C307529.pdf | 22uF ±20% 10V Ceramic Capacitor X5R 0805 | Samsung Electro-Mechanics | CL21A226MPCLRNC | 0805 | C307529
C9 | 1 | 100nF |  |  |  | Custom:CAPC2012X95N | https://www.lcsc.com/datasheet/C1852967.pdf | 100nF ±10% 10V Ceramic Capacitor X7R 0805 | YAGEO | CC0805KRX7R6BB104 | 0805 | C1852967
D1 | 1 | LED |  |  |  | Custom:XL-3528SURC | https://www.lcsc.com/datasheet/C2843800.pdf | LED RED WATER CLEAR SMD | XINGLIGHT | XL-3528SURC | SMD3528-2P | C2843800
FID1,FID2,FID3 | 3 | Fiducial |  | Excluded from BOM |  | Fiducial:Fiducial_1mm_Mask2mm | ~
J1 | 1 | Conn_01x02_Socket |  | Excluded from BOM |  | Connector_JST:JST_XH_B2B-XH-A_1x02_P2.50mm_Vertical | https://www.lcsc.com/datasheet/C158012.pdf | Connector Header 2 position 2.5mm Pitch 3A Through Hole -25℃~+85℃ | JST | B2B-XH-A(LF)(SN) | Through Hole,P=2.5mm | C158012
J2 | 1 | uart_flash |  |  |  | Connector_PinSocket_2.54mm:PinSocket_1x06_P2.54mm_Horizontal | https://www.lcsc.com/datasheet/C2897388.pdf | -40℃~+105℃ Right Angle 6P 3A 8.5mm 1x6P Side 2.54mm 1 Square Hole Through Hole,Right Angle,P=2.54mm Headers, Receptacles, Female Sockets RoHS | HCTL | PM254-1-06-W-8.5 | Through Hole,Right Angle,P=2.54mm | C2897388
L1 | 1 | 2.2uH |  |  |  | Custom:IND_LPS3015-222MRC | https://www.coilcraft.com/getmedia/5d262731-85ef-4348-8ab4-1044b4fc3cb8/lps3015.pdf | 2.2 µH Shielded - Inductor 1.4 A 110mOhm Max Nonstandard - | Coilcraft | LPS3015-222MRC | SMD,3x3mm | C2844756
MH1,MH2,MH3,MH4 | 4 | M3 |  | Excluded from BOM |  | MountingHole:MountingHole_3.2mm_M3 | ~
PS1 | 1 | TPS62162DSGR |  |  |  | Custom:SON50P200X200X80-9N | https://www.lcsc.com/datasheet/C40256.pdf | 2.25MHz Buck Fixed 3.3V 1A WSON-8-EP(2x2) Voltage Regulators - DC DC Switching Regulators RoHS | Texas Instruments | TPS62162DSGR | WSON-8-EP(2x2) | C40256
Q1 | 1 | AO3401A |  |  |  | Package_TO_SOT_SMD:SOT-23 | http://www.aosmd.com/pdfs/datasheet/AO3401A.pdf | 30V 4A Surface Mount SOT-23 | AOS | AO3401A | SOT-23 | C15127
R1,R2,R3,R5,R9,R10,R11 | 7 | 10k |  |  |  | Custom:RESC2012X60N | https://www.lcsc.com/datasheet/C84376.pdf | 125mW 10kΩ 150V Thick Film Resistor ±100ppm/℃ ±1% 0805 Chip Resistor - Surface Mount RoHS | YAGEO | RC0805FR-0710KL | 0805 | C84376
R4 | 1 | 150 |  |  |  | Custom:RESC2012X60N | https://www.lcsc.com/datasheet/C114523.pdf | 150Ω 125mW 150V Thick Film Resistor ±100ppm/℃ ±1% 0805 Chip Resistor - Surface Mount RoHS | YAGEO | RC0805FR-07150RL | 0805 | C114523
R6 | 1 | 330k |  |  |  | Custom:RESC2012X60N | https://www.lcsc.com/datasheet/C114528.pdf | 125mW 330kΩ 150V Thick Film Resistor ±100ppm/℃ ±1% 0805 Chip Resistor - Surface Mount RoHS | YAGEO | RC0805FR-07330KL | 0805 | C114528
R7,R12 | 2 | 100k |  |  |  | Custom:RESC2012X60N | https://www.lcsc.com/datasheet/C96346.pdf | 125mW 100kΩ 150V Thick Film Resistor ±100ppm/℃ ±1% 0805 Chip Resistor - Surface Mount RoHS | YAGEO | RC0805FR-07100KL | 0805 | C96346
R8 | 1 | 1M |  |  |  | Custom:RESC2012X60N | https://www.lcsc.com/datasheet/C107700.pdf | 125mW 1MΩ 150V Thick Film Resistor ±100ppm/℃ ±1% 0805 Chip Resistor - Surface Mount RoHS | YAGEO | RC0805FR-071ML | 0805 | C107700
S1,S2 | 2 | SKRPACE010 |  |  |  | Custom:SW_SKRPACE010 | https://www.lcsc.com/datasheet/C139797.pdf | Switch Tactile N.O. SPST Button J-Bend 0.05A 16VDC 2.55N SMD Automotive T/R | ALPSALPINE | SKRPACE010 | SMD-4P,4.2x3.2mm | C139797
U1 | 1 | ESP32-C3-MINI-1-N4 |  |  |  | Custom:XCVR_ESP32-C3-MINI-1-N4 | https://www.lcsc.com/datasheet/C2838502.pdf | Transceiver On-board PCB Antenna -98dBm SMD,16.6x13.2mm RF Transceiver Modules and Modems RoHS | Espressif Systems | ESP32-C3-MINI-1-N4 | SMD,16.6x13.2mm | C2838502
U4 | 1 | SHT40-AD1F-R2 |  |  |  | Custom:SHT4X | https://jlcpcb.com/api/file/downloadByFileSystemAccessId/8590907640283279360 | -40℃~+125℃ 0%RH~100%RH 1.08V~3.6V 16bit 400nA I2C ±0.2℃ ±1.8%RH DFN-4(1.5x1.5) Temperature and Humidity Sensor ROHS | Sensirion | SHT40-AD1F-R2 | DFN-4(1.5x1.5) | C7461846
