jiu-0317/sense_pcb_kicad/3D/SOT-23-3L_AOS.step

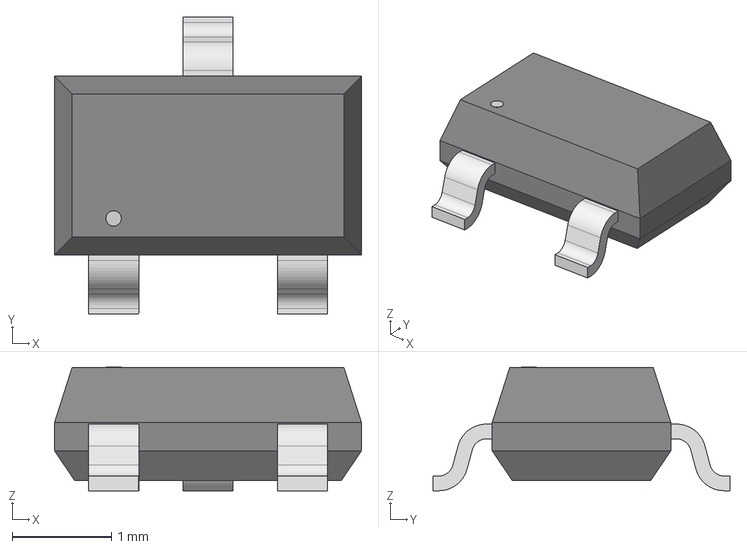
[picture p2: CAD file, 2026-11-04]
3D/SOT-23-3L_AOS.step
3.10 x 3.00 x 1.25 mm
