jiu-0317/sense_pcb_kicad/esp32_c3_mini_1_module.step

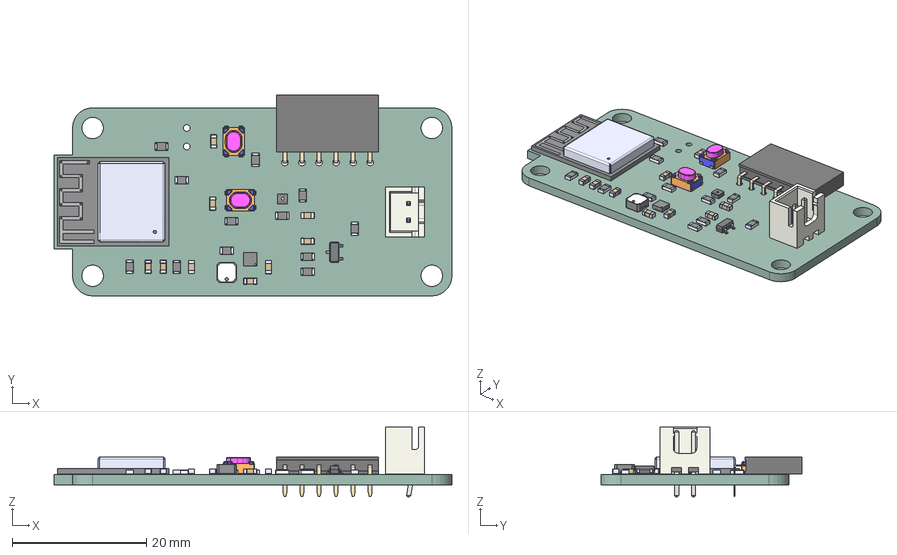
[picture p3: CAD file, 2026-11-04]
esp32_c3_mini_1_module.step
59.2 x 29.9 x 10.4 mm
RESC2012X60N x 12
CL21A226MPCLRNC x 9
PinSocket_1x06_P2.54mm_Horizontal
skrpace010 x 2
LPS3015-222MRC--3DModel-STEP-269445
SOT-23
ESP32-C3-MINI-1-N4
SHT40-AD1F-R2--3DModel-STEP-269445
TPS62162DSGR
JST_XH_B2B-XH-A_1x02_P2.50mm_Vertical
esp32_c3_mini_1_module_PCB
