jiu-0317/sense_pcb_kicad/xfl4015_inductor/XFL4015.STEP

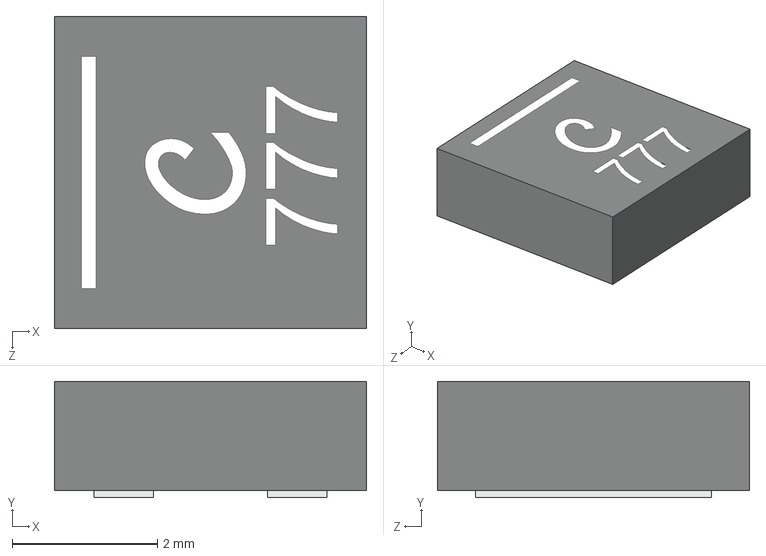
[picture p4: CAD file, 2026-11-06]
xfl4015_inductor/XFL4015.STEP
4.30 x 1.60 x 4.30 mm
