jiu-0317/sense_pcb_kicad/3D/skrpace010.stl

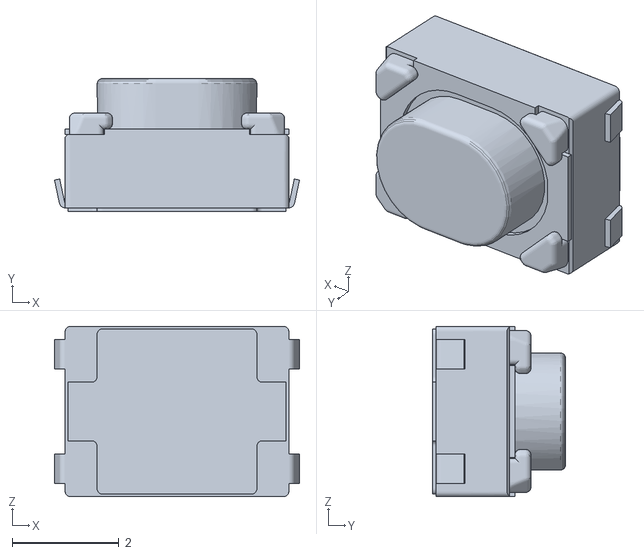
[picture p5: CAD file, 2026-11-04]
3D/skrpace010.stl
4.60 x 2.50 x 3.20
