jiu-0317/sense_pcb_kicad/3D/CL21A226MPCLRNC.STEP

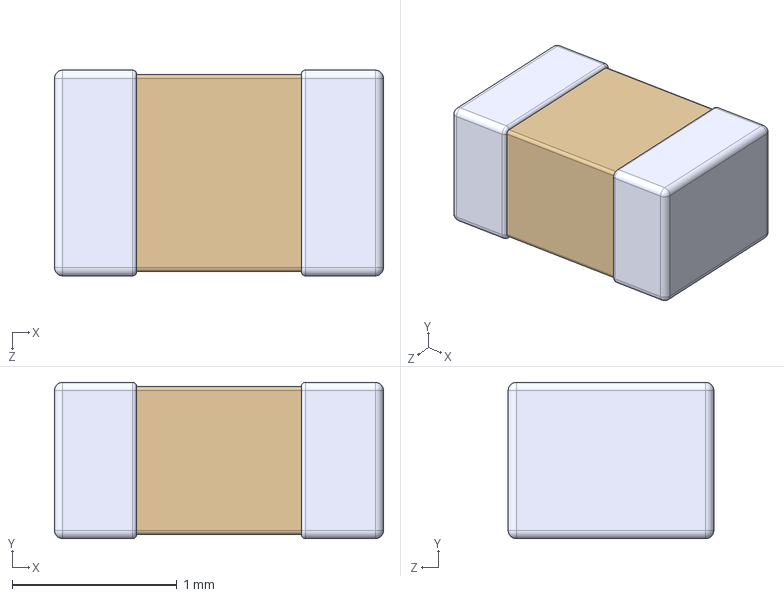
[picture p6: CAD file, 2026-11-04]
3D/CL21A226MPCLRNC.STEP
2.00 x 0.95 x 1.25 mm
