jiu-0317/sense_pcb_kicad/(list of files, cad)

Other CAD files:
esp32_c3_mini_1_module.stl
