jiu-0317/sense_pcb_kicad/SCH_ESP32-C3-DEVKITM-1_V1_20200915A.pdf

# System Block:

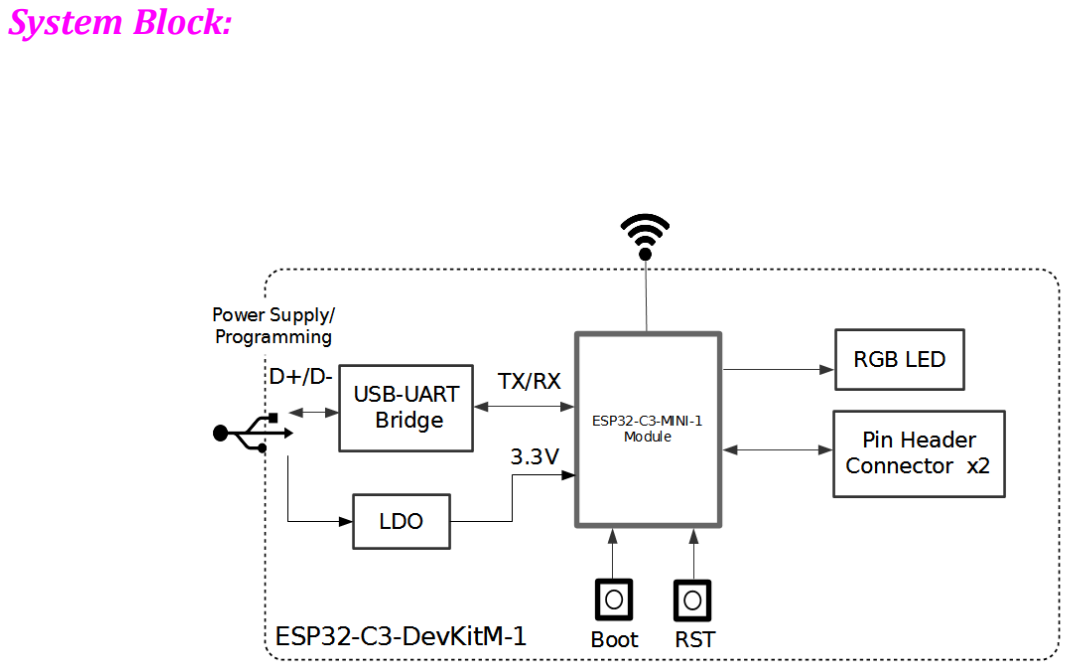
[picture p7: page 1]
Title; Size; Document Number; Rev; Date:; Sheet; <01_DesignBlock>; ESP32-C3-DevKitM-1; Tuesday, September 15, 2020

NC8 | 25 IO18 | 26 IO19 | 27 NC9 | 28 NC10 | 29 RXD0 | 30 TXD0 | 31 NC11 | 32 NC12 | 33 NC13 | 34 NC14 | 35

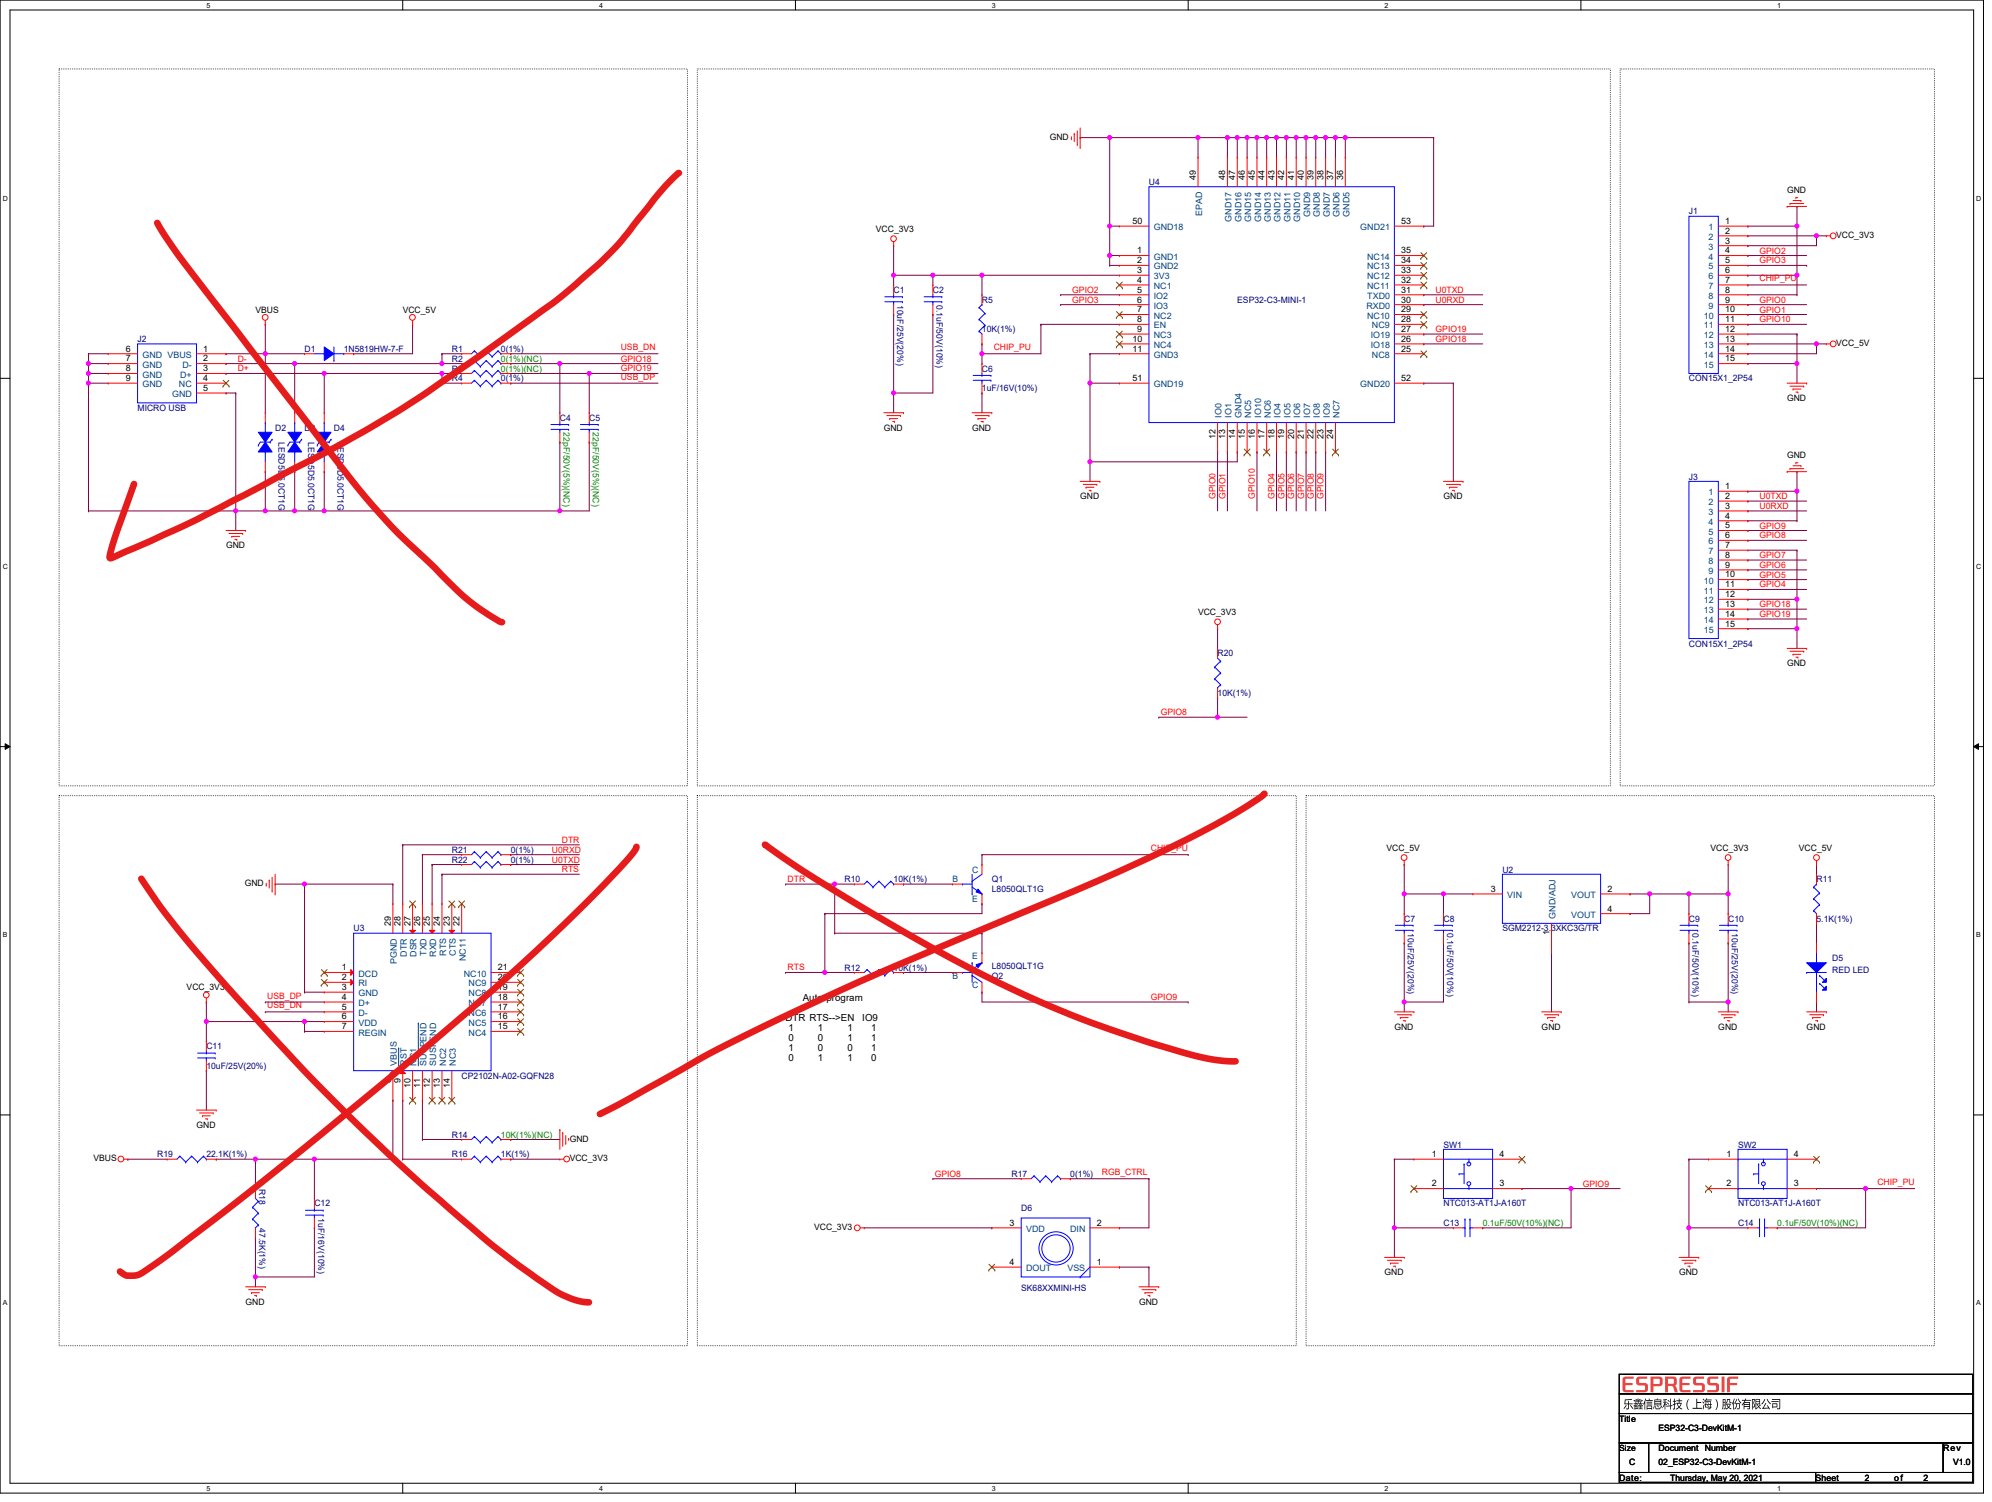
[picture p8: page 2]
