jiu-0317/sense_pcb_kicad/BH-AAA-3J.pdf

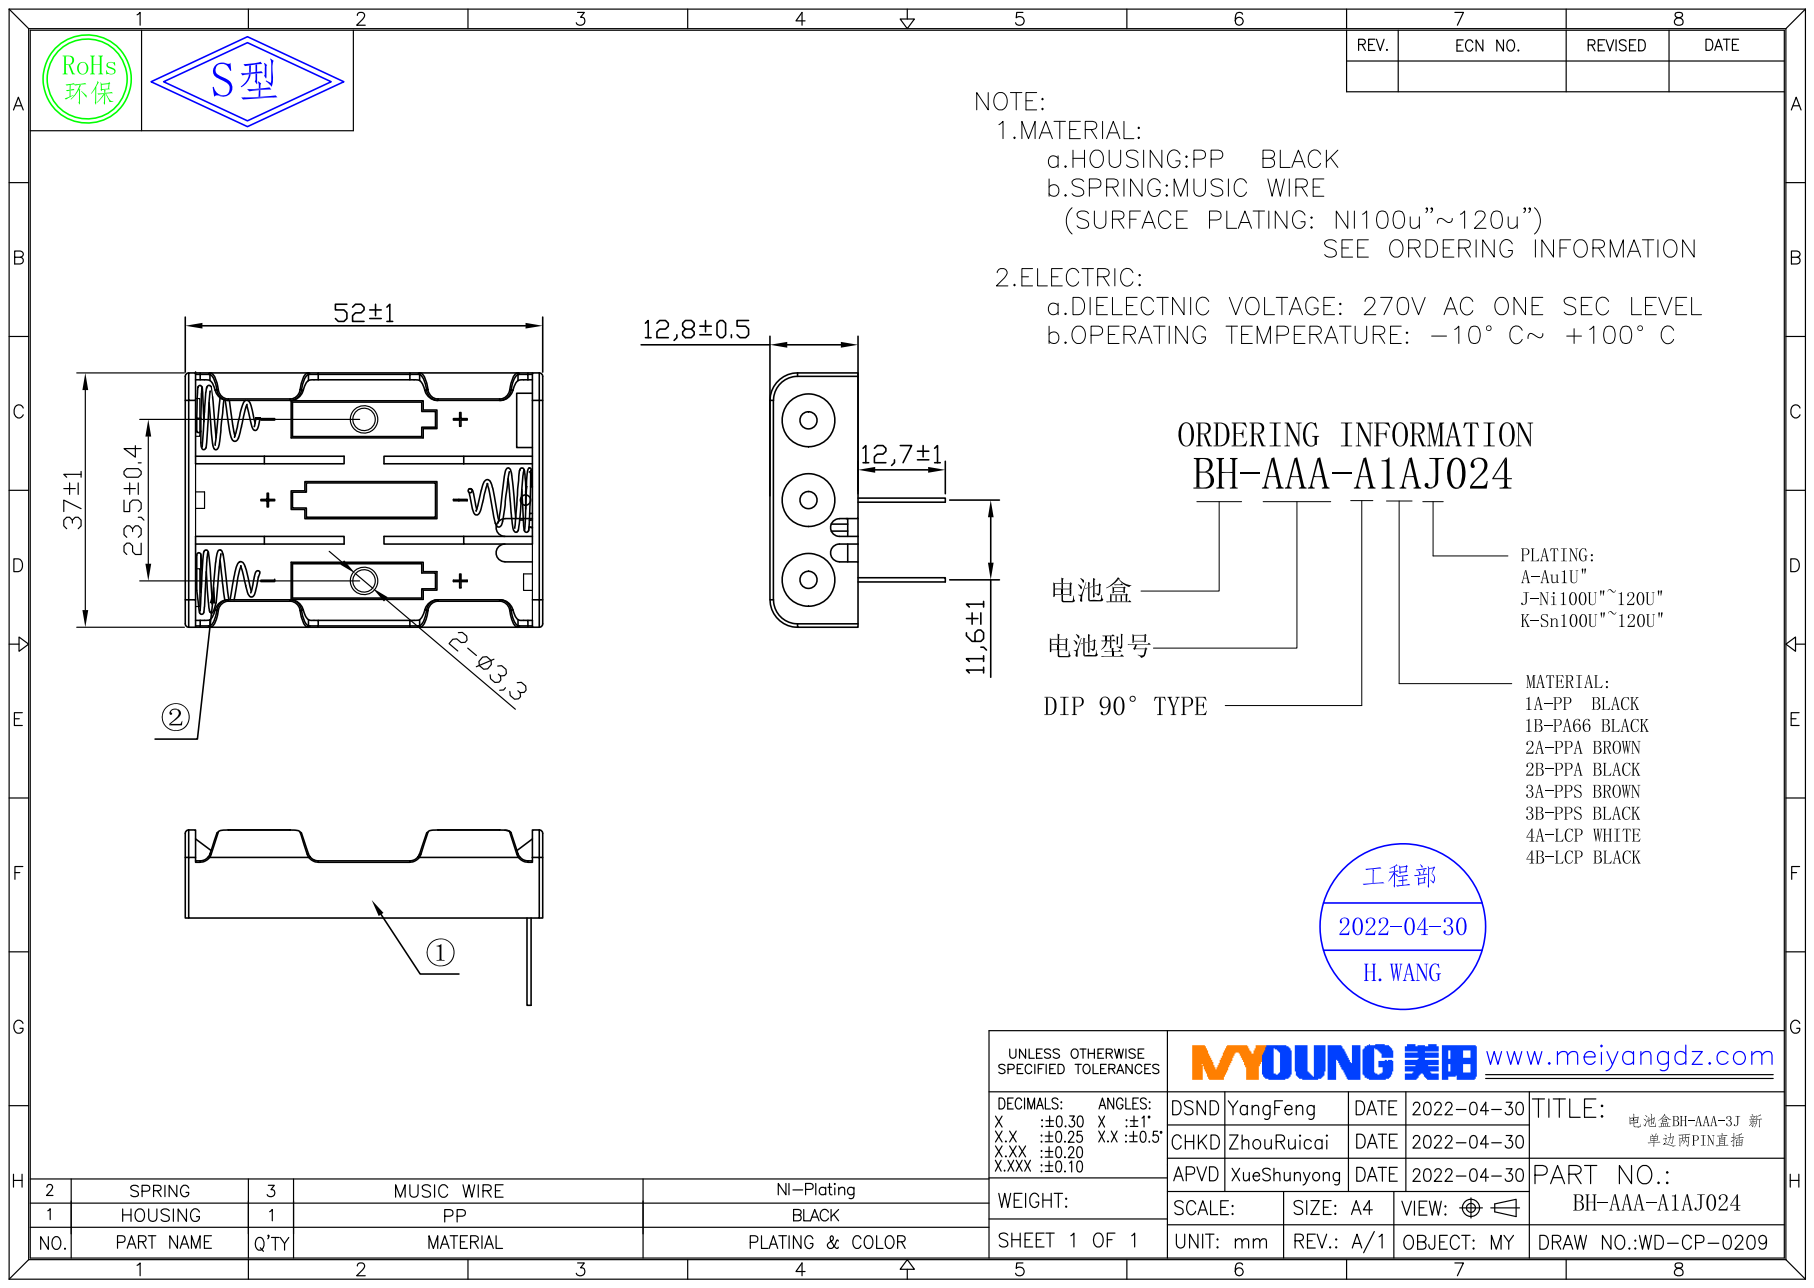
[picture p9: page 1]
