jiu-0317/sense_pcb_kicad/esp32_c3_mini_1_module.kicad_pcb

## KiCad design esp32_c3_mini_1_module.kicad_pcb (2026-11-10)

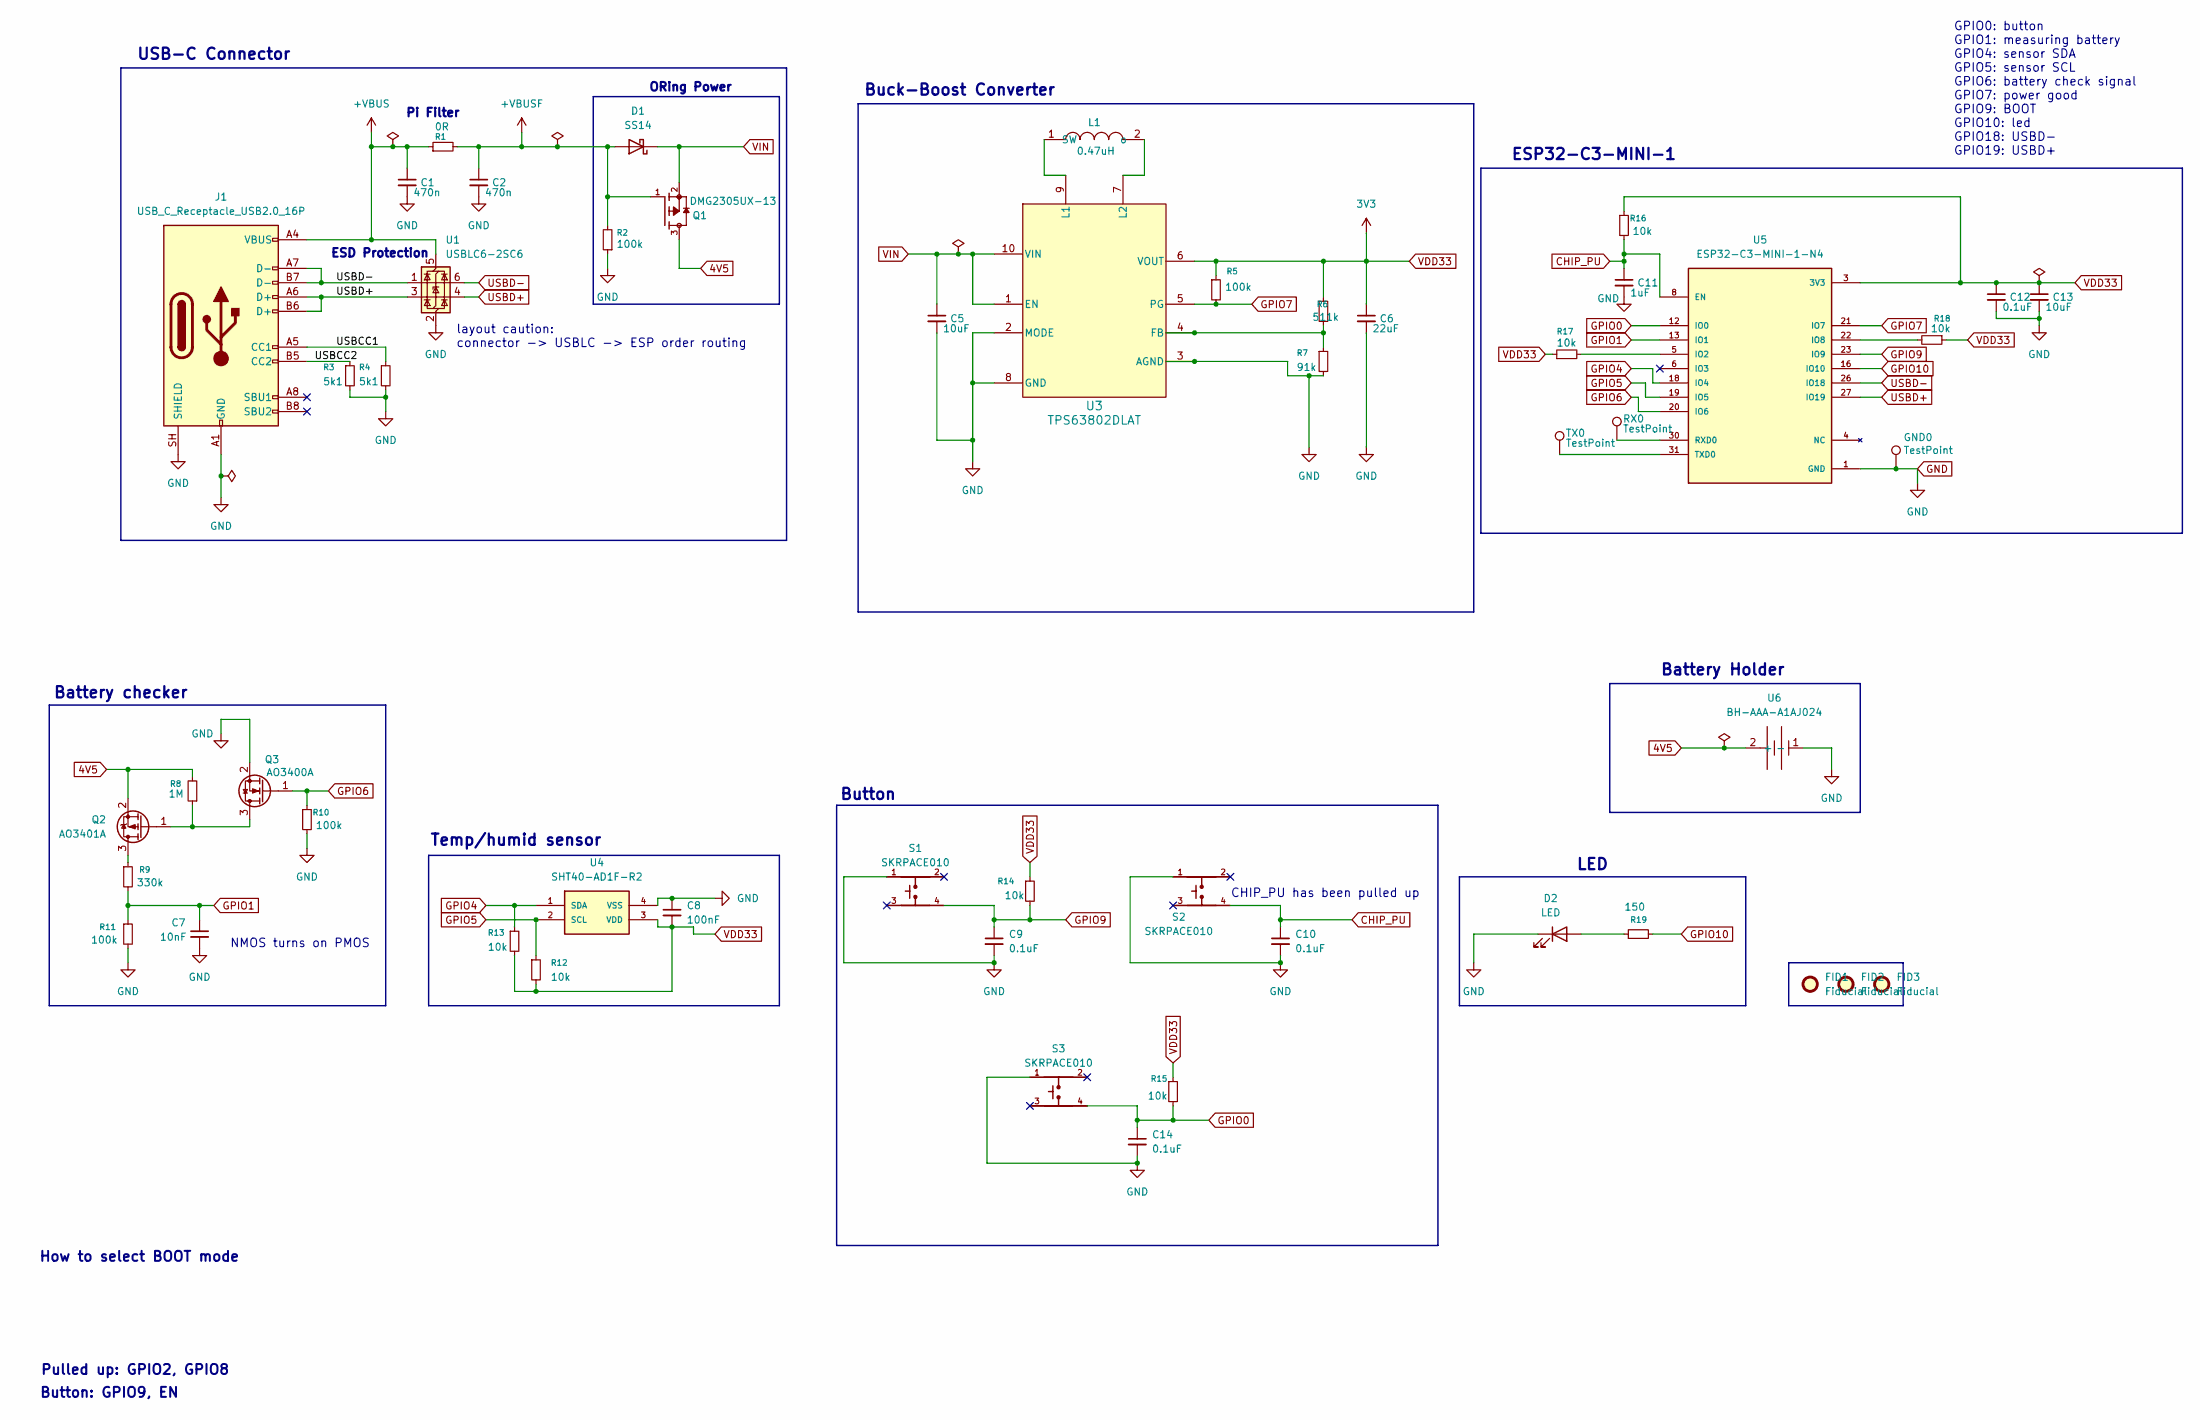
[picture p10: schematic esp32_c3_mini_1_module.kicad_sch, TEMP/HUMID SENSING BOARD]

Parts:
C1, C2: 470n; CAPC2012X95N; MF_part_number CL21B105KBFNNNE; LCSC C28323
C5: 10uF; CAPC2012X95N; MF_part_number CL21B105KBFNNNE; LCSC C28323
C6: 22uF; CAPC2012X95N; MF_part_number CL21B105KBFNNNE; LCSC C28323
C7: 10nF; CAPC2012X95N; MF_part_number CL21B103KBANNNC; LCSC C1710
C8: 100nF; CAPC2012X95N; MF_part_number CC0805KRX7R6BB104; LCSC C1852967
C9, C10, C12, C14: 0.1uF; CAPC2012X95N; MF_part_number CC0805KRX7R6BB104; LCSC C1852967
C11: 1uF; CAPC2012X95N; MF_part_number CL21B105KBFNNNE; LCSC C28323
C13: 10uF; CAPC2012X95N; MF_part_number CL21A106KPFNNNE; LCSC C17024
D1: SS14; D_SMA; MF_part_number SS14-E3/61T; LCSC C47460
D2: LED; XL-3528SURC; MF_part_number XL-3528SURC; LCSC C2843800
FID1, FID2, FID3: Fiducial; Fiducial_1mm_Mask2mm
GND0: TestPoint; TestPoint_Pad_D1.5mm
J1: USB_C_Receptacle_USB2.0_16P; USB_C_Receptacle_GCT_USB4105-xx-A_16P_TopMnt_Horizontal; MF_part_number USB4105-GF-A-060; LCSC C3025063
L1: 0.47uH; xfl4015_inductor; MF_part_number XFL4015-471MEC; LCSC C18221164
Q1: DMG2305UX-13; MPN DMG2305UX-13; LCSC C144153
Q2: AO3401A; SOT-23; MF_part_number AO3401A; LCSC C15127
Q3: AO3400A; SOT-23
R1: 0R; RESC2012X60N; MF_part_number RC0805FR-0710KL; LCSC C84376
R2: 100k; RESC2012X60N; MF_part_number RC0805FR-0710KL; LCSC C84376
R3, R4: 5k1; RESC2012X60N; MF_part_number RC0805FR-0710KL; LCSC C84376
R5, R10, R11: 100k; RESC2012X60N; MF_part_number RC0805FR-07100KL; LCSC C96346
R6: 511k; RESC2012X60N; MF_part_number RC0805FR-0710KL; LCSC C84376
R7: 91k; RESC2012X60N; MF_part_number RC0805FR-0710KL; LCSC C84376
R8: 1M; RESC2012X60N; MF_part_number RC0805FR-071ML; LCSC C107700
R9: 330k; RESC2012X60N; MF_part_number RC0805FR-07330KL; LCSC C114528
R12, R13, R14, R15, R16, R17, R18: 10k; RESC2012X60N; MF_part_number RC0805FR-0710KL; LCSC C84376
R19: 150; RESC2012X60N; MF_part_number RC0805FR-07150RL; LCSC C114523
RX0: TestPoint; TestPoint_Pad_D1.5mm
S1, S2, S3: SKRPACE010; SW_SKRPACE010; MF_part_number SKRPACE010; LCSC C139797
TX0: TestPoint; TestPoint_Pad_D1.5mm
U1: USBLC6-2SC6; SOT-23-6; MF_part_number USBLC6-2SC6; LCSC C7519
U3: TPS63802DLAT; MF_part_number TPS63802DLAT; LCSC C1849531
U4: SHT40-AD1F-R2; SHT4X; MF_part_number SHT40-AD1F-R2; LCSC C7461846
U5: ESP32-C3-MINI-1-N4; XCVR_ESP32-C3-MINI-1-N4; PARTREV v1.0; LCSC C2838502
U6: BH-AAA-A1AJ024; BAT-TH_BH-AAA-A1AJ024; MPN BH-AAA-A1AJ024; LCSC Part C5290193

Connections:
4V5: Q1.3, Q2.2 (S), R8.2, U6.2 (+)
+VBUS: C1.1, J1.A4 (VBUS), J1.A9 (VBUS), J1.B4 (VBUS), J1.B9 (VBUS), R1.1, U1.5 (VBUS)
+VBUSF: C2.1, D1.2 (A), Q1.1, R1.2, R2.2
/USBCC1: J1.A5 (CC1), R4.1
/USBCC2: J1.B5 (CC2), R3.1
CHIP_PU: C10.1, C11.1, R16.2, S2.4, U5.8 (EN)
GND: C1.2, C2.2, C5.2, C6.2, C7.2, C8.1, C9.2, C10.2, C11.2, C12.2, C13.2, C14.2, D2.1 (K), GND0.1 (1_1), J1.A1 (GND), J1.A12 (GND), J1.B1 (GND), J1.B12 (GND), J1.SH (SHIELD), Q3.2 (S), R2.1, R3.2, R4.2, R7.2, R10.2, R11.2, S1.1, S2.1, S3.1, U1.2 (GND), U3.2 (MODE), U3.3 (AGND), U3.8 (GND), U4.4 (VSS), U5.1 (GND), U5.2 (GND), U5.11 (GND), U5.14 (GND), U5.36 (GND), U5.37 (GND), U5.38 (GND), U5.39 (GND), U5.40 (GND), U5.41 (GND), U5.42 (GND), U5.43 (GND), U5.44 (GND), U5.45 (GND), U5.46 (GND), U5.47 (GND), U5.48 (GND), U5.49_1 (GND), U5.49_2 (GND), U5.49_3 (GND), U5.49_4 (GND), U5.49_5 (GND), U5.49_6 (GND), U5.49_7 (GND), U5.49_8 (GND), U5.49_9 (GND), U5.50 (GND), U5.51 (GND), U5.52 (GND), U5.53 (GND), U6.1 (-)
GPIO0: C14.1, R15.2, S3.4, U5.12 (IO0)
GPIO1: C7.1, R9.2, R11.1, U5.13 (IO1)
GPIO4: R13.1, U4.1 (SDA), U5.18 (IO4)
GPIO5: R12.1, U4.2 (SCL), U5.19 (IO5)
GPIO6: Q3.1 (G), R10.1, U5.20 (IO6)
GPIO7: R5.2, U3.5 (PG), U5.21 (IO7)
GPIO9: C9.1, R14.2, S1.4, U5.23 (IO9)
GPIO10: R19.2, U5.16 (IO10)
unnamed: D2.2 (A), R19.1
unnamed: L1.1 (SW), U3.9 (L1)
unnamed: L1.2 (o), U3.7 (L2)
unnamed: Q2.3 (D), R9.1
unnamed: Q2.1 (G), Q3.3 (D), R8.1
unnamed: R6.2, R7.1, U3.4 (FB)
unnamed: R17.2, U5.5 (IO2)
unnamed: R18.2, U5.22 (IO8)
unnamed: RX0.1 (1_1), U5.30 (RXD0)
unnamed: TX0.1 (1_1), U5.31 (TXD0)
USBD+: J1.A6 (D+), J1.B6 (D+), U1.3 (I/O2), U1.4 (I/O2), U5.27 (IO19)
USBD-: J1.A7 (D-), J1.B7 (D-), U1.1 (I/O1), U1.6 (I/O1), U5.26 (IO18)
VDD33: C6.1, C8.2, C12.1, C13.1, R5.1, R6.1, R12.2, R13.2, R14.1, R15.1, R16.1, R17.1, R18.1, U3.6 (VOUT), U4.3 (VDD), U5.3 (3V3)
VIN: C5.1, D1.1 (K), Q1.2, U3.1 (EN), U3.10 (VIN)

Notes on the sheet:
LED
Button: GPIO9, EN
GPIO0: button GPIO1: measuring battery GPIO4: sensor SDA GPIO5: sensor SCL GPIO6: battery check signal GPIO7: power good GPIO9: BOOT GPIO10: led GPIO18: USBD- GPIO19: USBD+
Pulled up: GPIO2, GPIO8
Pi Filter
ORing Power
Battery Holder
Buck-Boost Converter
USB-C Connector
ESP32-C3-MINI-1
layout caution: connector -> USBLC -> ESP order routing
Battery checker
Temp/humid sensor
NMOS turns on PMOS
Button
CHIP_PU has been pulled up
How to select BOOT mode
ESD Protection

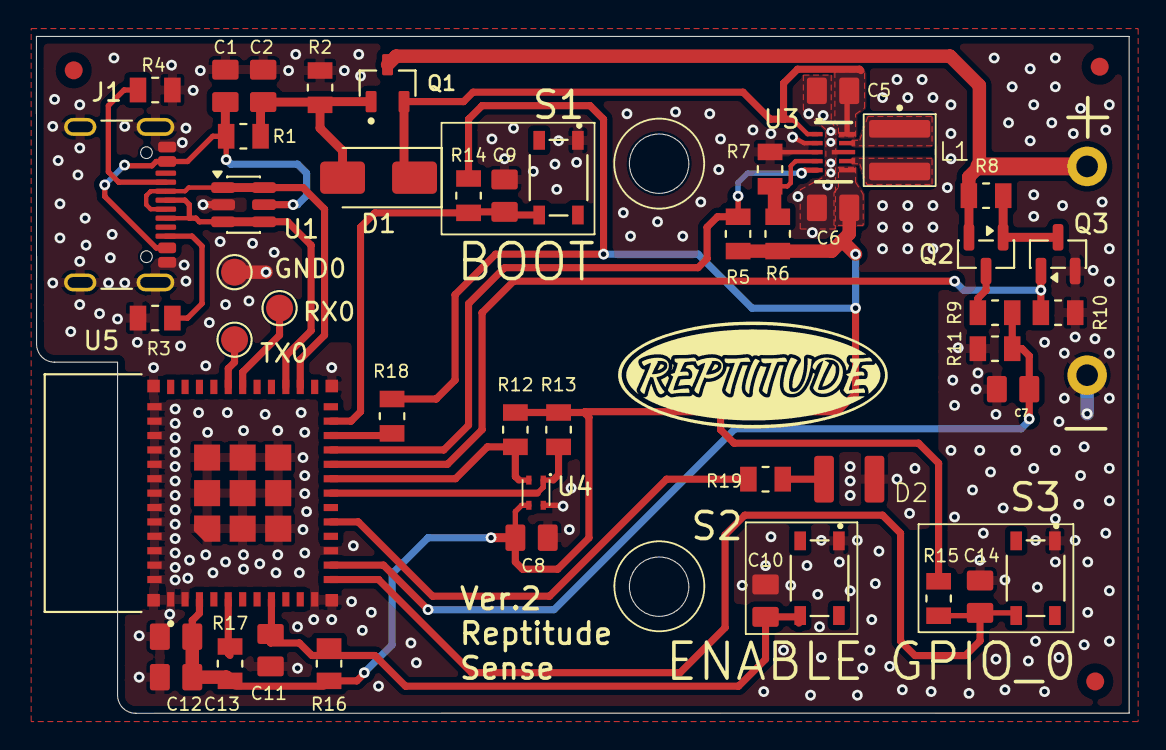
[picture p11: board esp32_c3_mini_1_module.kicad_pcb from above]

Board: 2 copper layers, 60.7 x 37.6 mm, 52 parts (1 on the bottom side), 29 nets.
