jiu-0317/sense_pcb_kicad/(commit log)

2026-11-05 schematic edited
2026-11-09 schematic/UART converter removed
2026-11-09 schematic/test point added, UART converter removed, battery checker modified
2026-11-10 PCB/routing finished
